ThomasKulin/CG-490/Report/simulations/FEMM/BasicSim Field Intensity.PNG

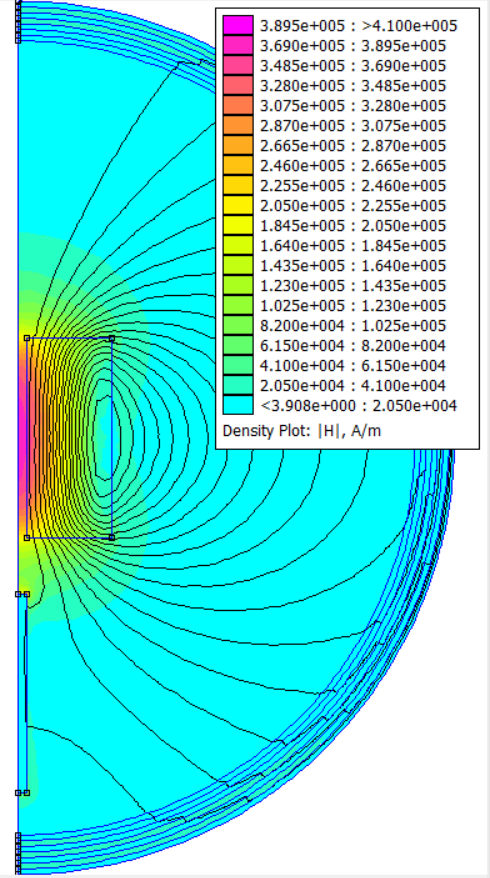
Report/simulations/FEMM/BasicSim Field Intensity.PNG
