ThomasKulin/CG-490/Report/shematics + boards/PowerSwitchV1 3d.PNG

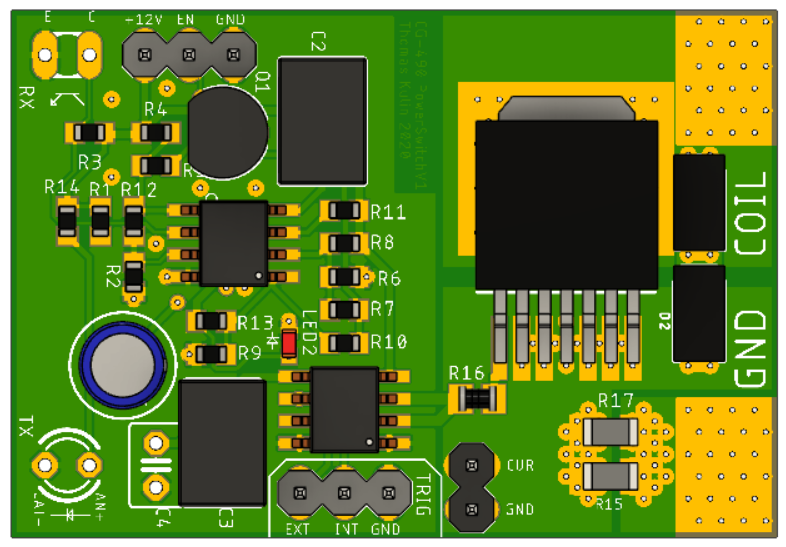
Report/shematics + boards/PowerSwitchV1 3d.PNG
