ThomasKulin/CG-490/README.md

# CG-490
shooting stuff with electricity. yes
