ThomasKulin/CG-490/Cool Links.txt

Insprational Projects

full auto bb gun. good aesthetic: https://www.eevblog.com/forum/projects/my-electromagnetic-bb-gun-project-130-ms-velocity-20-rpm-rate-of-fire/
Battery powered, tons of helpful info: https://4hv.org/e107_plugins/forum/forum_viewtopic.php?p=1&id=147269
CG42 THE ONE THE ONLY: https://4hv.org/e107_plugins/forum/forum_viewtopic.php?p=6&id=100083

Concepts

diode suppression: https://4hv.org/e107_plugins/forum/forum_viewtopic.php?p=1&id=147858

Components

Digital logic optical sensor: https://www.digikey.com/product-detail/en/OPB819Z/365-1262-ND/1015177
Mosfet alternative (cheaper): https://www.digikey.ca/product-detail/en/STP310N10F7/497-13233-5-ND/3598099
gate driver: https://www.digikey.ca/product-detail/en/microchip-technology/MCP1407-E-SN/MCP1407-E-SN-ND/1228639
TVS diode: https://www.digikey.ca/product-detail/en/littelfuse-inc/SMDJ28A/SMDJ28ACT-ND/1835367
Barrel: https://www.amazon.ca/Clear-Polycarbonate-Tubing-Wall-Length/dp/B000OM9JPG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
