ThomasKulin/CG-490/Papers/final presentation example.pdf

# Multistage Coil Gun

## Final Presentation

Team 3

Yohan Ko, Jon Dagdagan, Shashvat Nanavati TA: Ryan May
ECE 445

Friday April 26, 2013

Benefits
- Controllable projectile
speed
- Portable, easy to
assemble
- Educational tool to teach electromagnetism

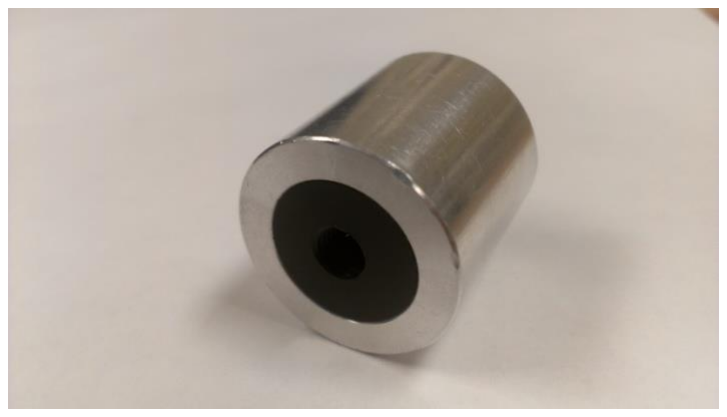
[picture p62: figure]

Features
- Isolation of high voltage components
- Sensing capabilities in
launch barrel
- Fast capacitor recharge time

Objectives
•Eject projectile at speeds of 12-17 m/s •Trigger successive stage efficiently •Ensure operator and system safety •Design for modularity
•Make project permanent EOH exhibit

## Coil Gun Theory

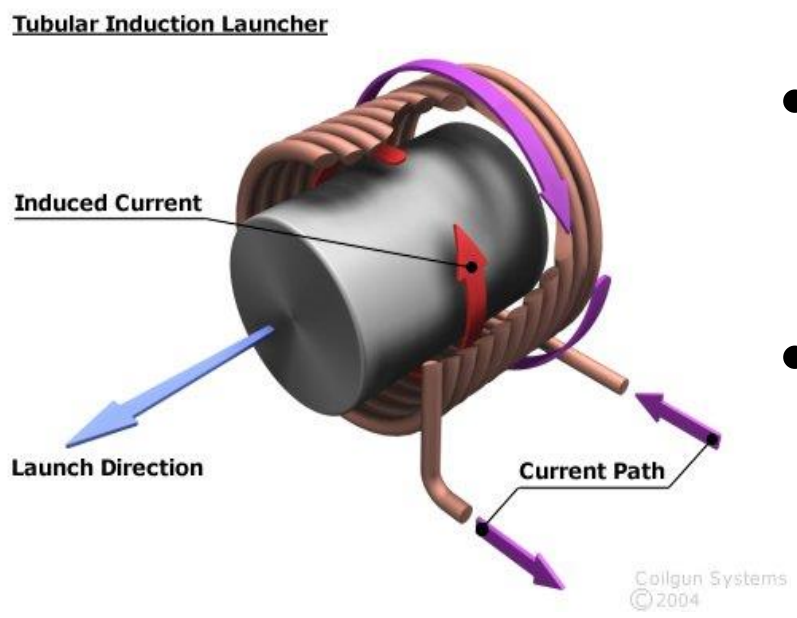
[picture p63: figure]

## - Lenz’s Law

– Induced surface
currents

## - Opposing currents repel each other

Figure taken from [2]

## Overview

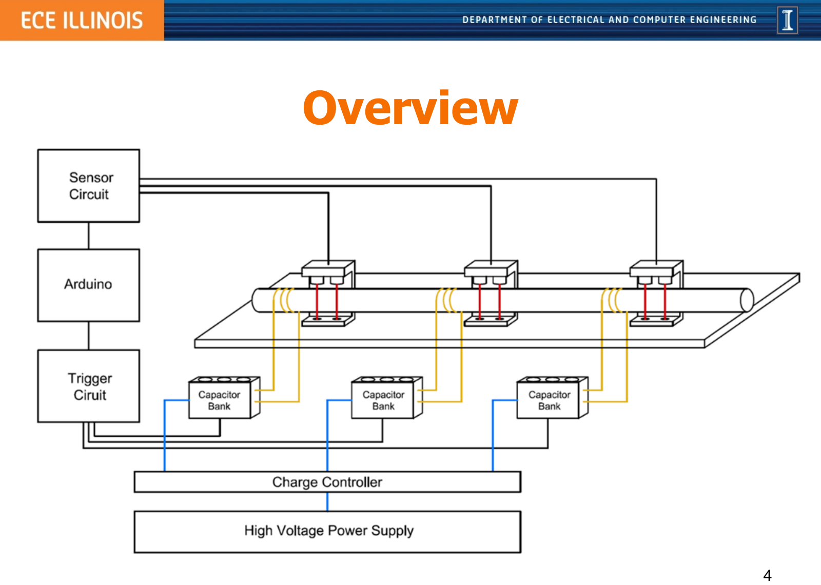
[picture p64: page 4]

## Charge Controller and HV Power Supply

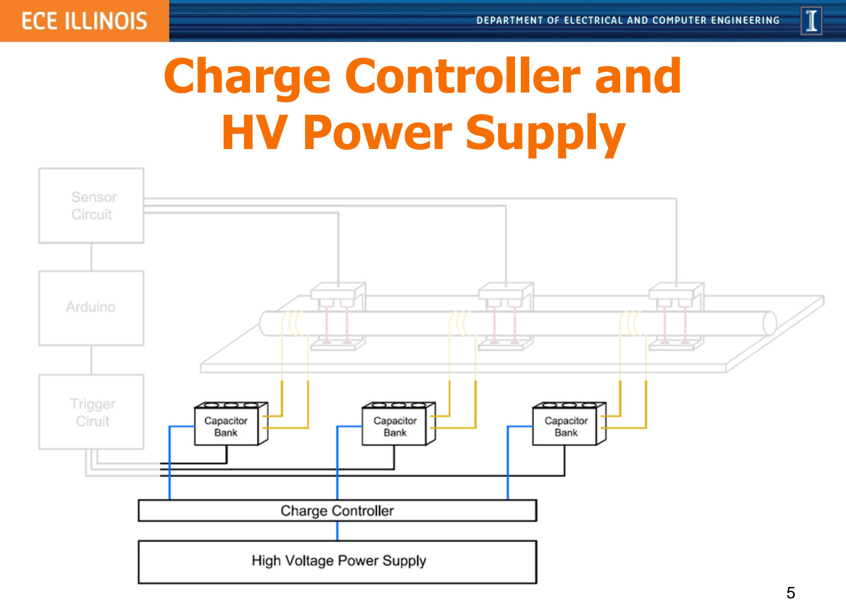
[picture p65: page 5]

## Charge Controller and HV Power Supply

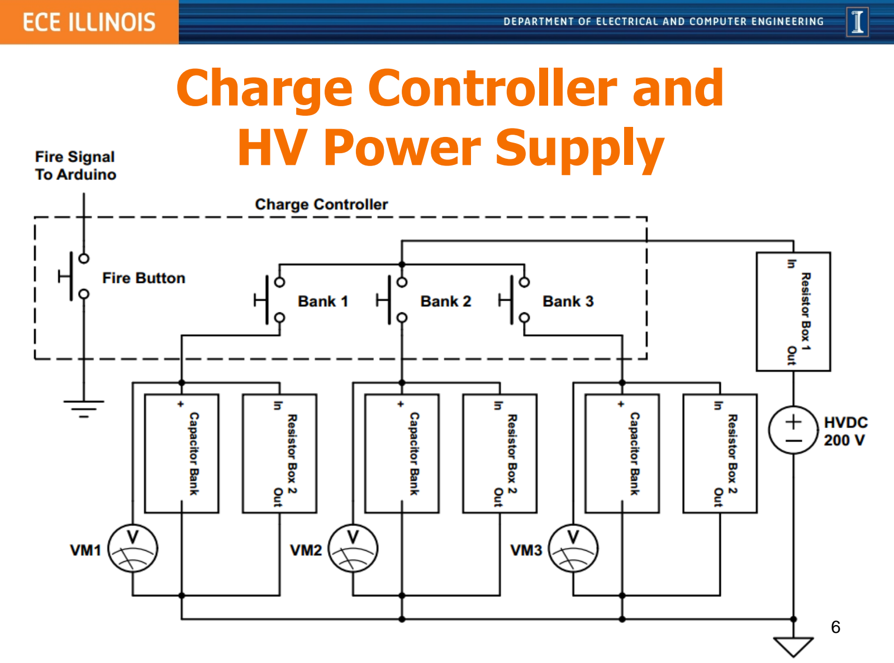
[picture p66: page 6]

## Sensor Circuit

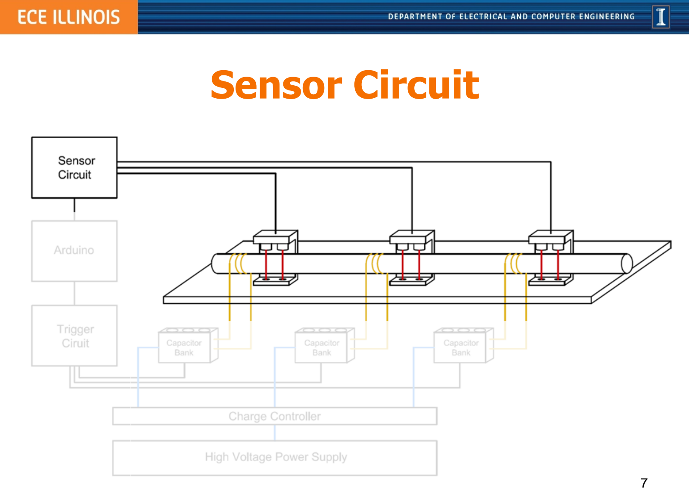
[picture p67: page 7]

## Sensor Circuit

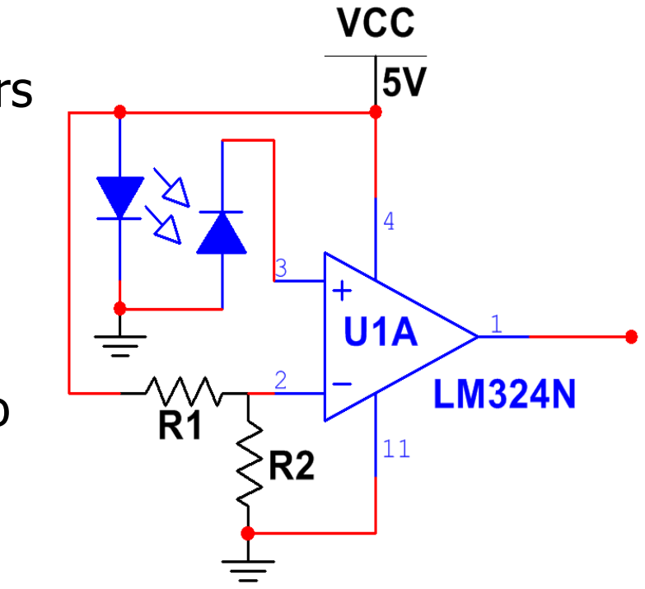
[picture p68: figure]

- Interface between lasers and Arduino
- Detects voltage drop
when projectile passes
lasers
- Outputs stable signal to Arduino

## Sensor Circuit

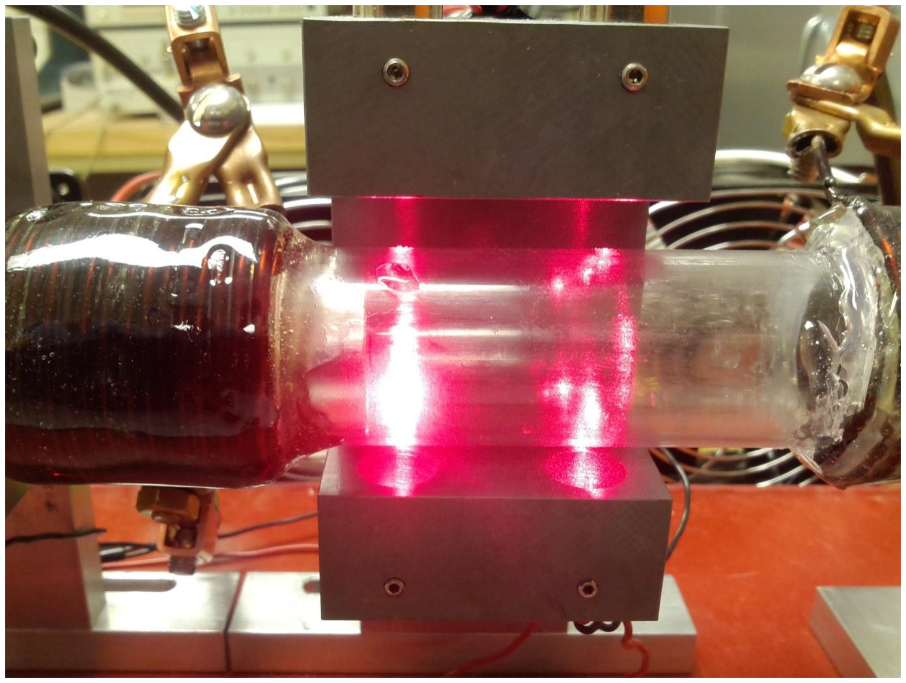
[picture p69: figure]

## Microcontroller

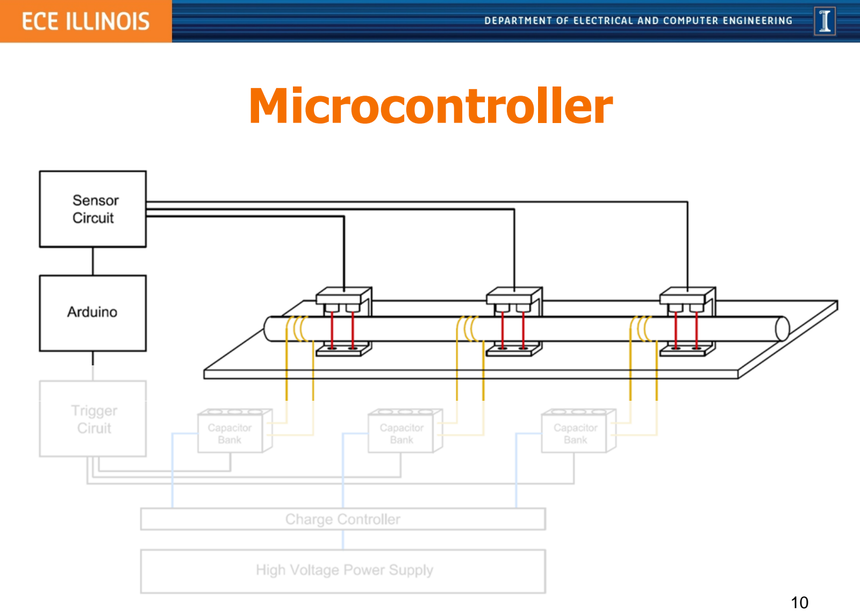
[picture p70: page 10]

## Microcontroller

- Uses Arduino Uno

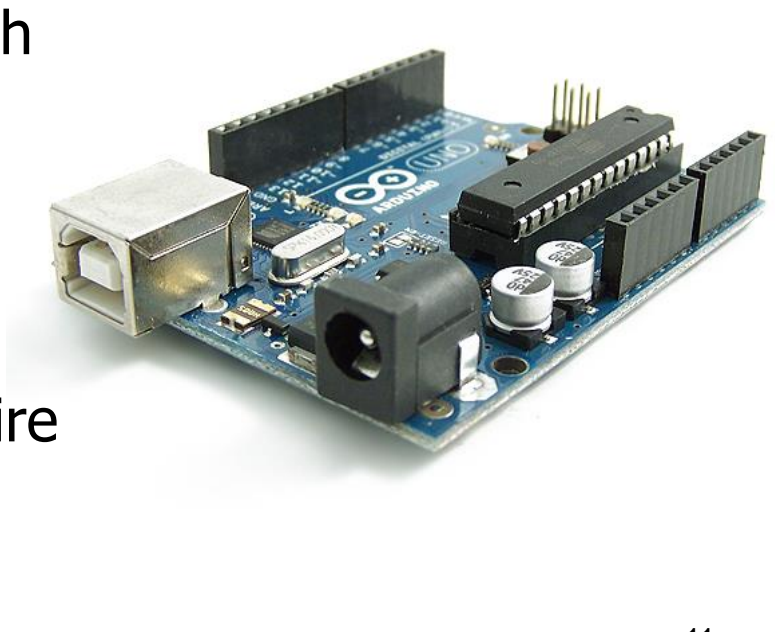
[picture p71: figure]

- Records times at which
voltage of photodiode
drops
- Calculates speed of
projectile
- Determines when to fire
next stage

## Trigger Circuit

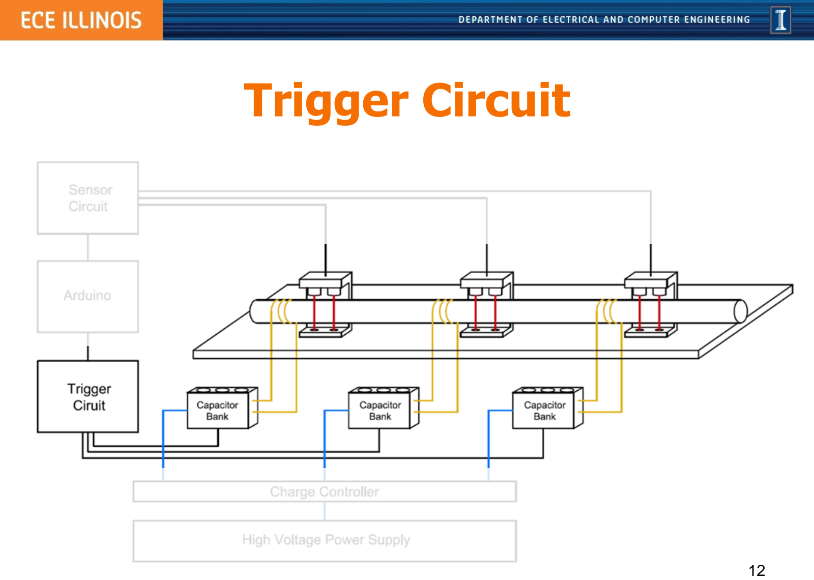
[picture p72: page 12]

## Trigger Circuit

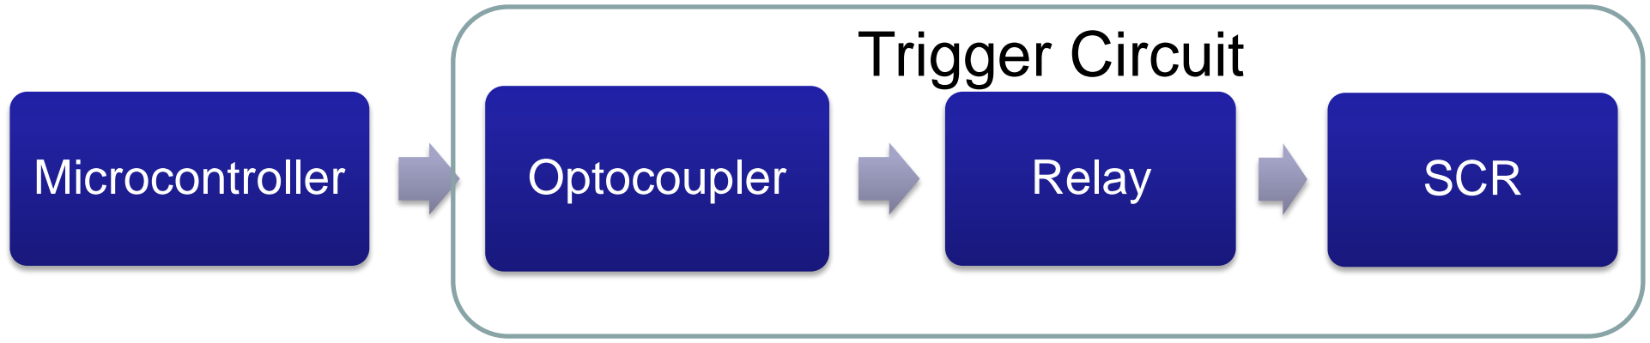
[picture p73: figure]
Microcontroller; Optocoupler; Relay; SCR; Trigger Circuit

- Optocoupler provides isolation from HV power supply
- Relay drives the gate of SCR to turn SCR on
- SCR remains latched on until all current is discharged

## Trigger Circuit

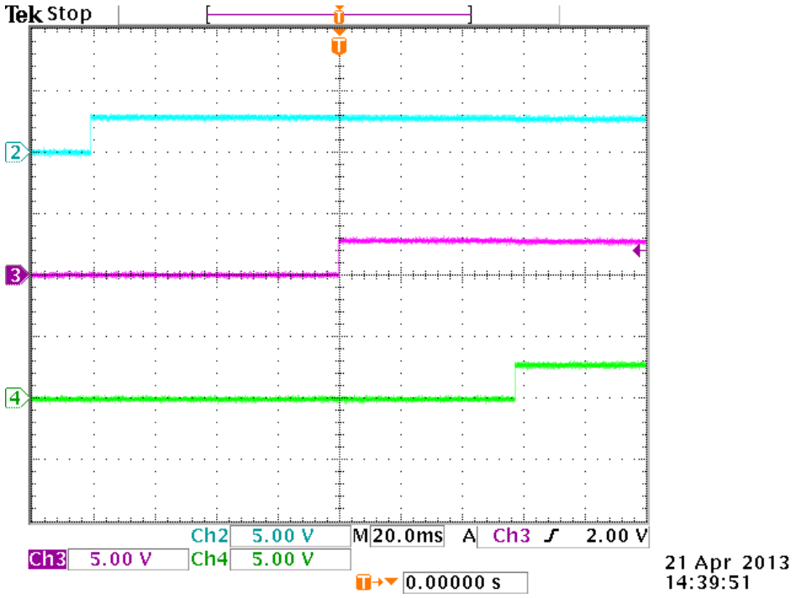
[picture p74: figure]

Sequential Triggering of Capacitor Banks

## Coil Windings

### - Coil windings connected to each capacitor bank - Design Considerations

– Minimum resistance
- Place two windings in parallel for each stage – Maximum mutual inductance
- length of winding = length of projectile
- diameter of winding = diameter of projectile

## Simulations

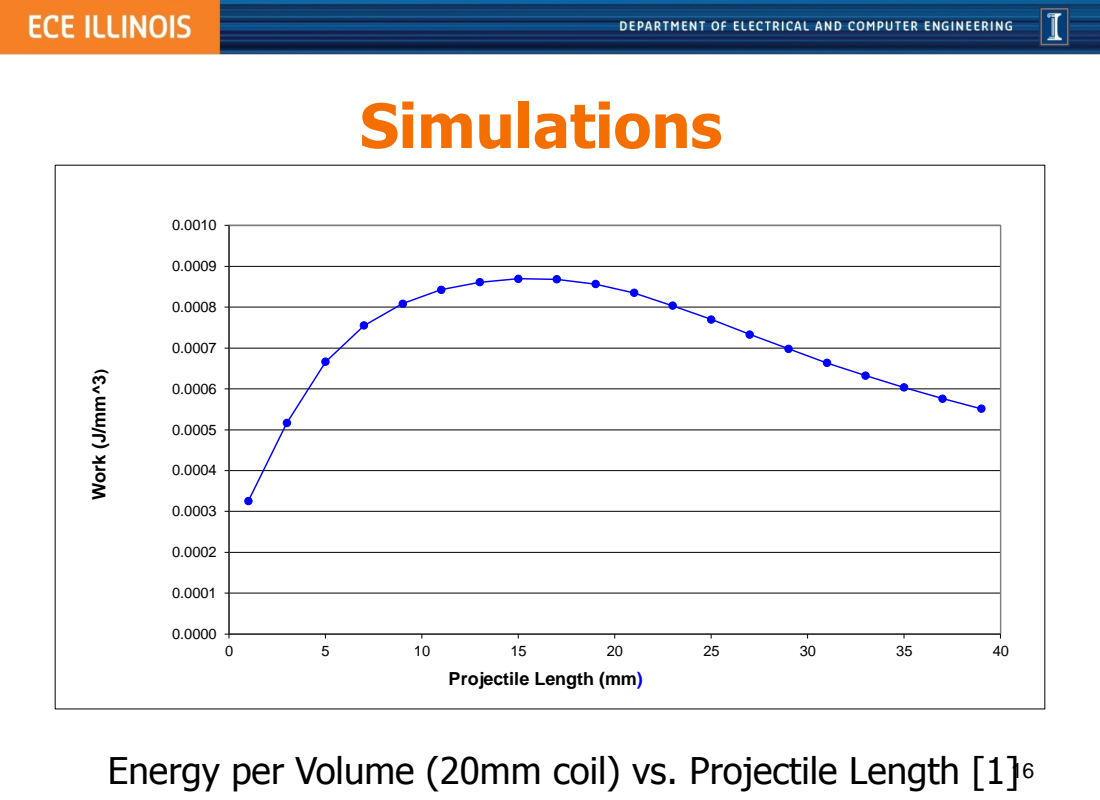
[picture p75: page 16]
Work (J/mm^3)

Projectile Length (mm)

Energy per Volume (20mm coil) vs. Projectile Length [1]

## Simulations

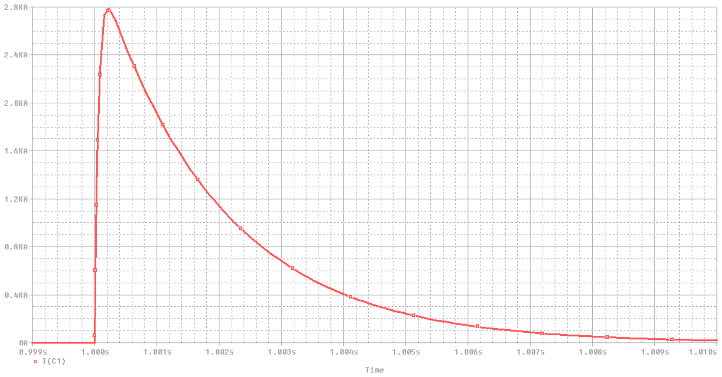
[picture p76: figure]

Peak Current Plot | 17

Requirement | Verification
- Calculate and use speed of projectile to obtain discharge time | • Push projectile through barrel and ensure monitor displays logged times and speed
- 2400 V isolation between HV power supply and Arudino | • Ensure resistance across DC power relay is in 10MΩ range
- Relay output signal powerful enough to activate SCRs | • Ensure relay outputs 3V±20% with 500mA±20%

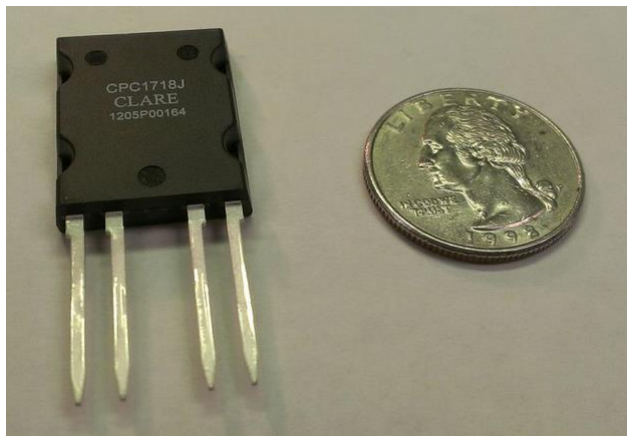
[picture p77: figure]

Challenges | Solutions
- False triggering from noise | • Decoupling capacitors
- High component stress | • Smaller diameter barrel • Operate at lower voltage
- High voltage safety | • Capacitor bank enclosure • Safety procedures
- Magnetic field interference | • Twisted wires to cancel magnetic fields • Shielded wire
- Arduino failure | • Proper grounding practice

## Ethics

1. To accept responsibility in making decisions consistent with the safety, health, and welfare of the public, and to disclose promptly factors that might endanger the public or the environment.
3. To be honest and realistic in stating claims or estimates based on available data.
7. To seek, accept, and offer honest criticism of technical work, to acknowledge and correct errors, and to credit properly the contributions of others.
9. To avoid injuring others, their property, reputation, or employment by false or malicious action.

## Safety Features

- Capacitor bank enclosures
- Capacitor bank shorting rods
- Side insertion plugs for wiring modularity

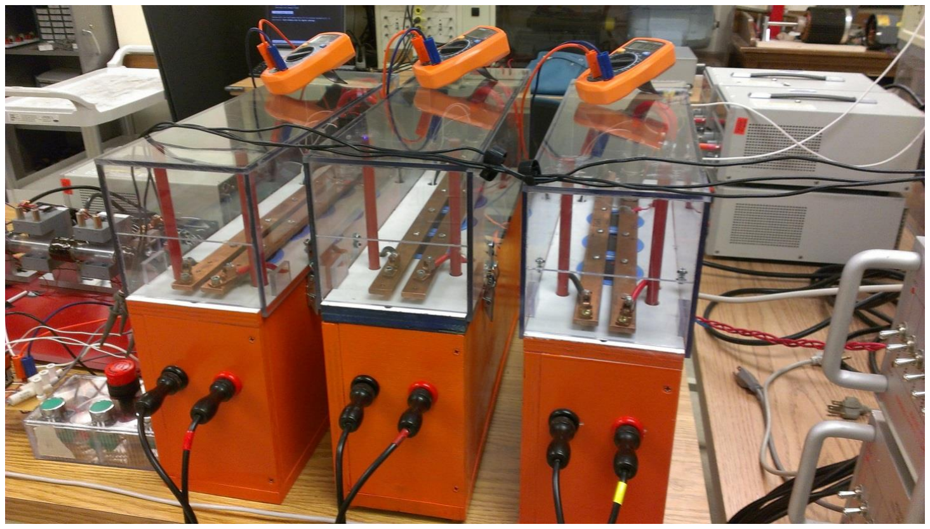
[picture p78: figure]

## Safety Features

- Use of multiple SCRs in parallel
- Safety plans for connect/disconnect/operation

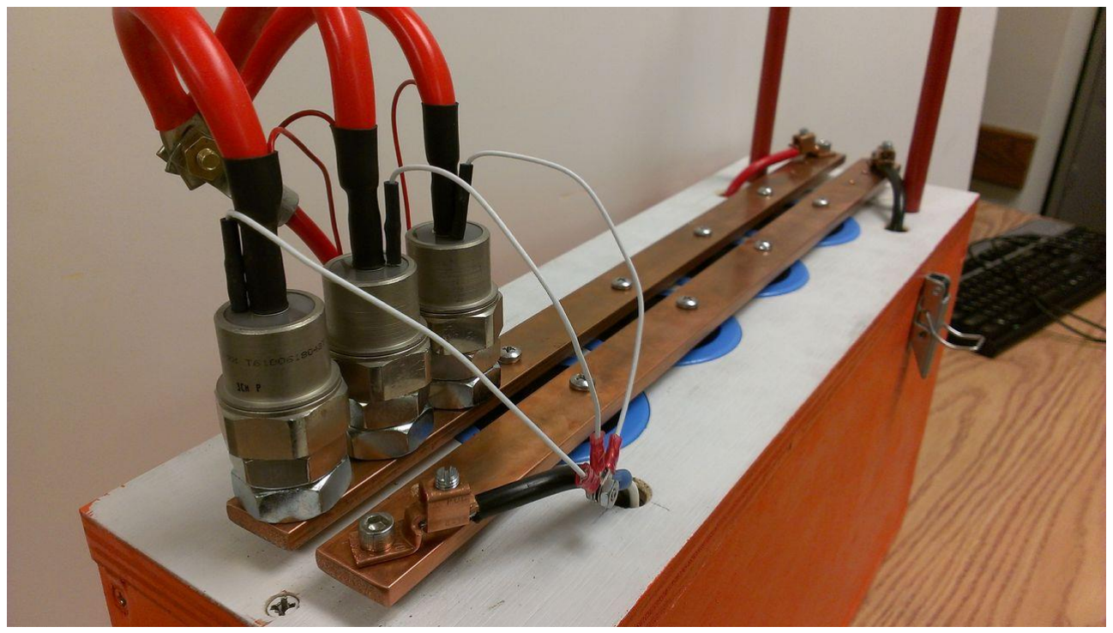
[picture p79: figure]

## Engineering Open House

### - Prototype demonstration successful

– Won 2nd in “Back to School” category
– Operated over 100 times over two days
– Consistently achieved projectile speeds of 14-17 m/s

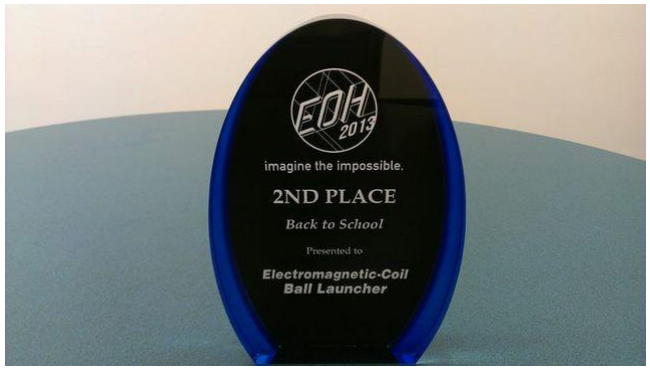
[picture p80: figure]

## Engineering Open House

### - Lessons Learned

– Windings need to be more secure
– Signals need to be immune from field interference – Need to lower current stress levels on SCR
– Capacitor voltages can rise after disconnection

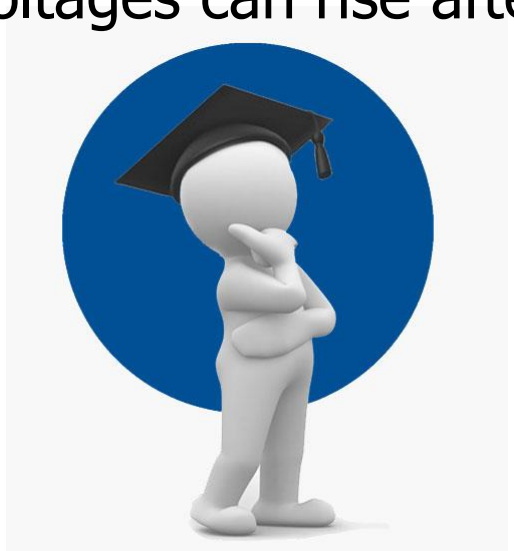
[picture p81: figure]

## Functionality Demonstration

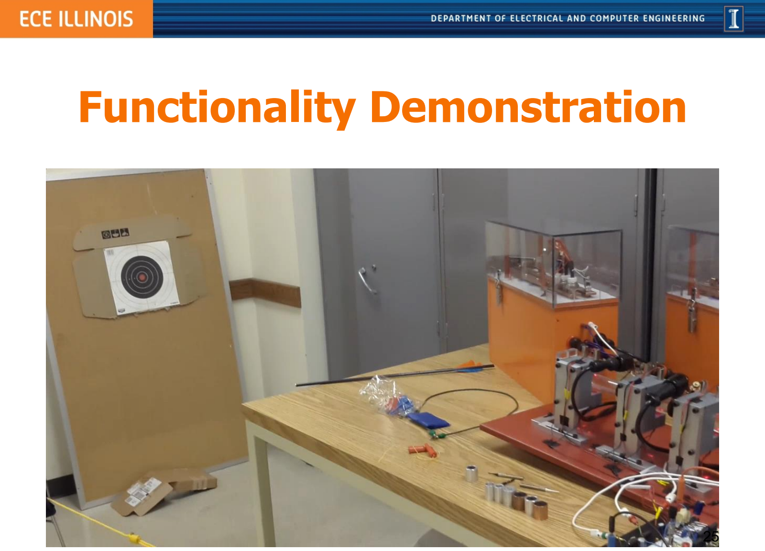
[picture p82: page 25]

## Next Steps

## - Continue Coil Gun EOH exhibit - Silk-screened PCB - Enclosure for barrel

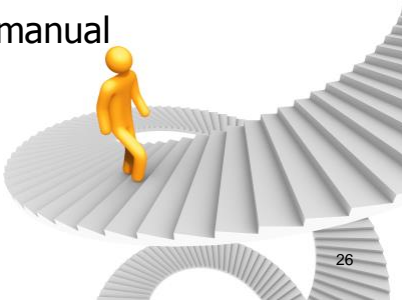
[picture p83: figure]

## - Create operational manual

## Thank You

## - Special thanks to:

– Ryan May
– Karl Reinhard
– Shawn Reinhard
– Christopher Barth
– Dr. Scott Carney
– Friends from the Machine and Parts shop – Kevin Colravy

## Questions?

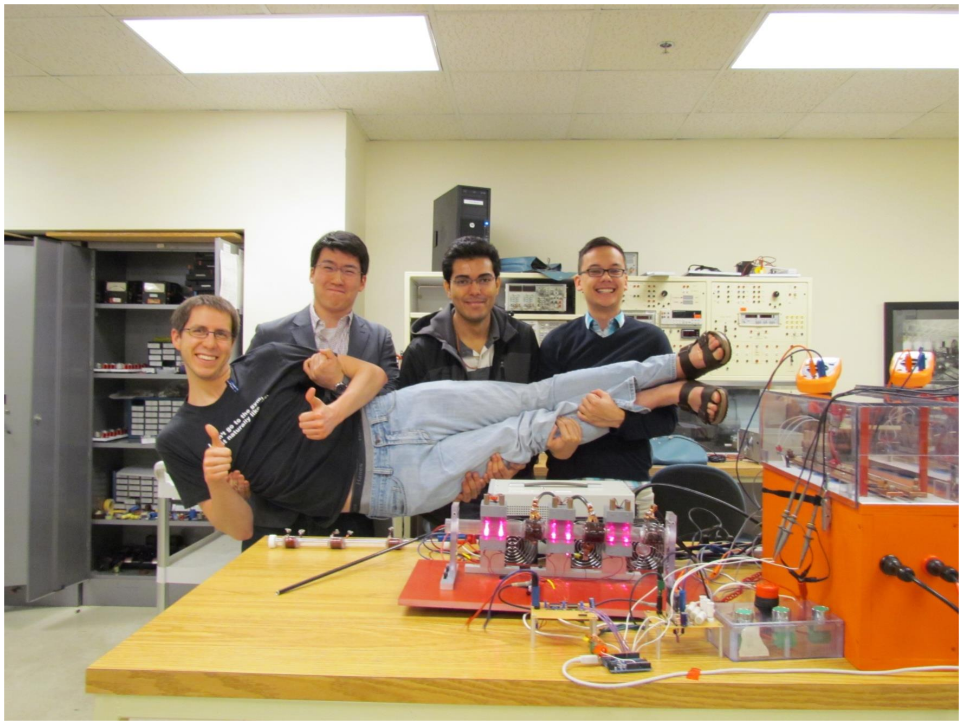
[picture p84: figure]

## References

[1] Hansen, Barry. (2013) Solving Solid Cylindrical Projectile of various lengths. Available:
http://www.coilgun.info/femm/projectile_length/projectile_length_results.txt
[2] Paul, James. (2006) Coilgun Basics.
Available: http://www.coilgun.eclipse.co.uk/coilgun_basics_1.html
