ThomasKulin/CG-490/FEMM Simulations/Data/3.2mmCoil_100T_246A Force vs. Projectile distance.png

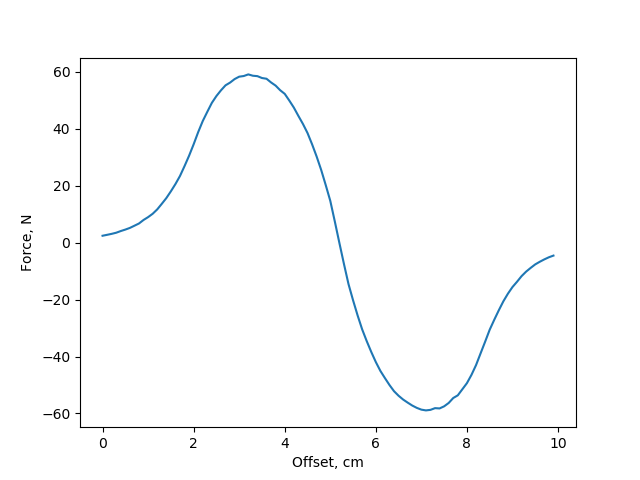
FEMM Simulations/Data/3.2mmCoil_100T_246A Force vs. Projectile distance.png
