ThomasKulin/CG-490/FEMM Simulations/Data/7mmCoil_192T_156A Force vs. Projectile distance.png

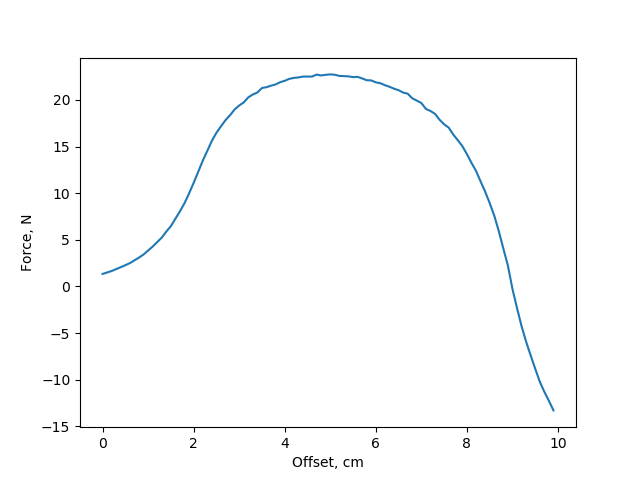
FEMM Simulations/Data/7mmCoil_192T_156A Force vs. Projectile distance.png
