ThomasKulin/CG-490/Report/Datasheets/STP310NF10F7 SOA.PNG

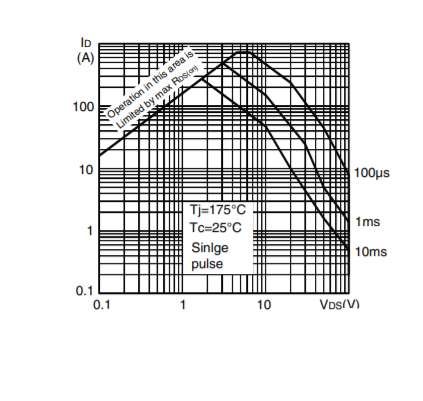
Report/Datasheets/STP310NF10F7 SOA.PNG
