ThomasKulin/CG-490/Report/Lorentz Force Graphic.png

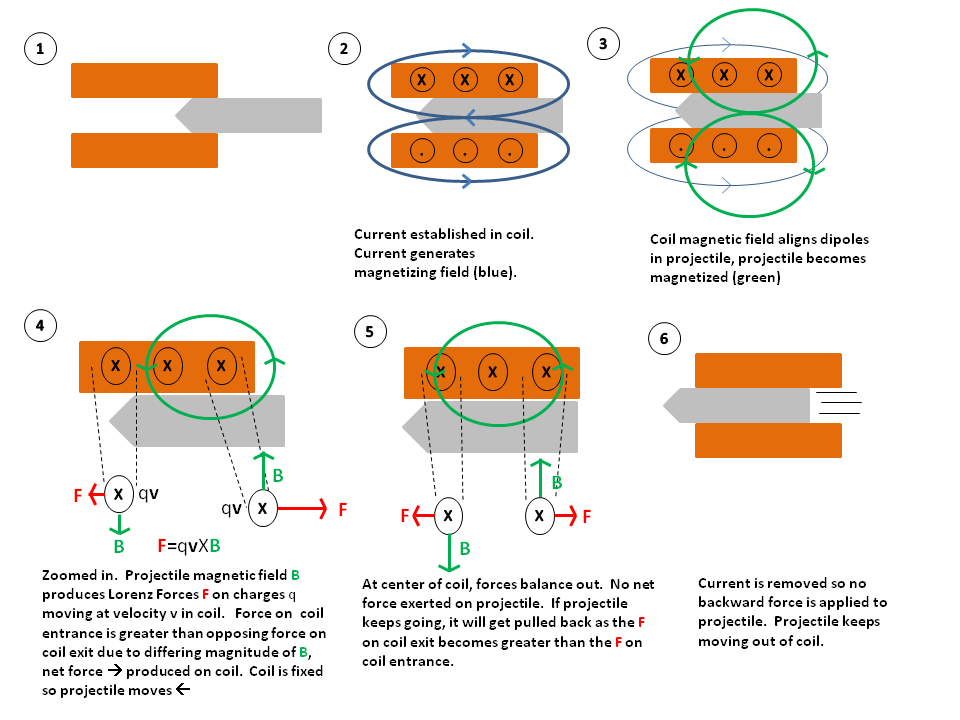
Report/Lorentz Force Graphic.png
