ThomasKulin/CG-490/Report/shematics + boards/PowerSwitchV1 brd.PNG

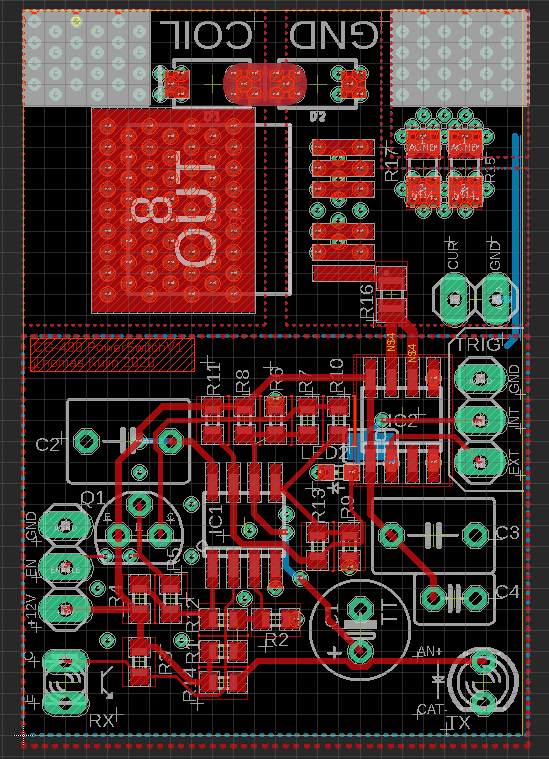
Report/shematics + boards/PowerSwitchV1 brd.PNG
