ThomasKulin/CG-490/Report/shematics + boards/PowerSwitchV1 sch.PNG

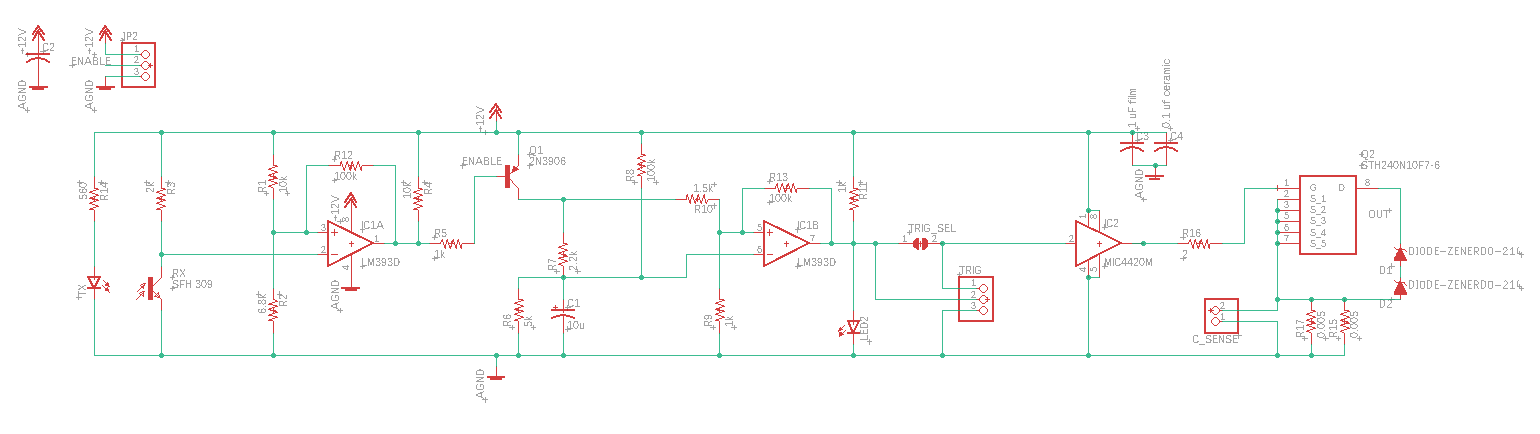
Report/shematics + boards/PowerSwitchV1 sch.PNG
