ThomasKulin/CG-490/Report/shematics + boards/Proto_V1.jpg

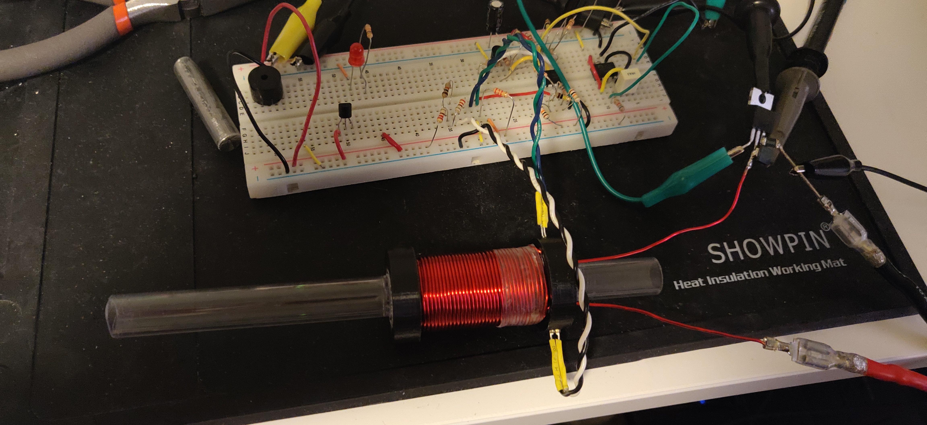
Report/shematics + boards/Proto_V1.jpg
