ThomasKulin/CG-490/Report/simulations/SPICE/Antiparallel Diode Waveform.PNG

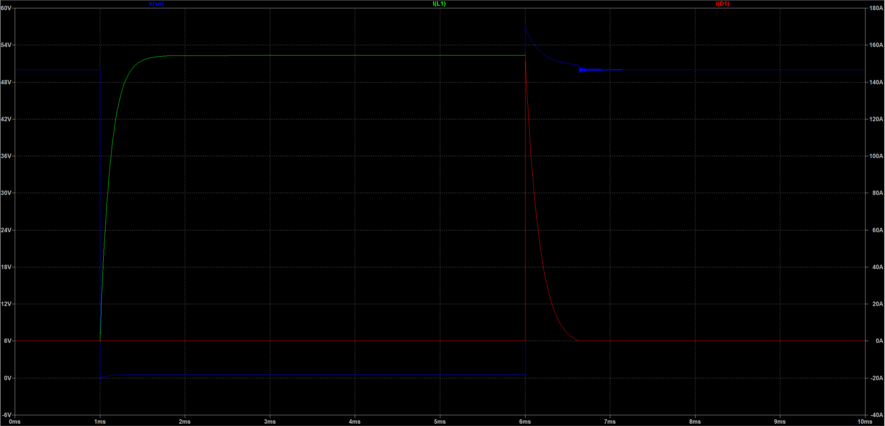
Report/simulations/SPICE/Antiparallel Diode Waveform.PNG
