ThomasKulin/CG-490/Report/simulations/SPICE/Diodeless Waveform.PNG

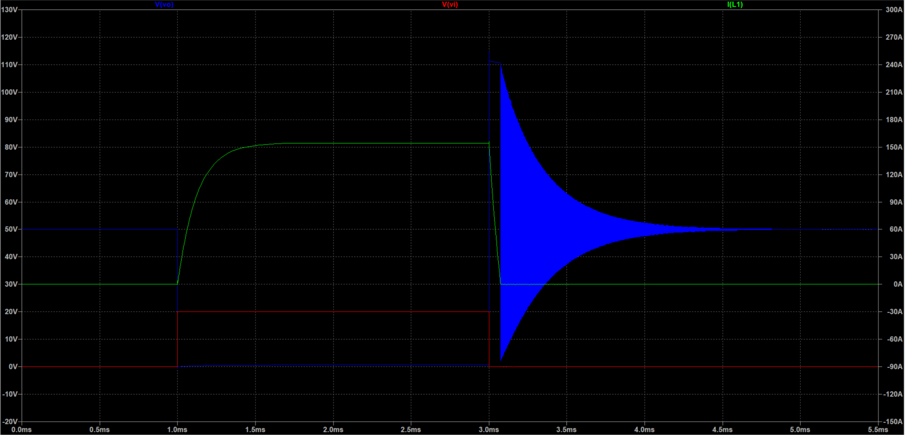
Report/simulations/SPICE/Diodeless Waveform.PNG
