ThomasKulin/CG-490/Report/simulations/SPICE/LTSpice D_AntiParallel.PNG

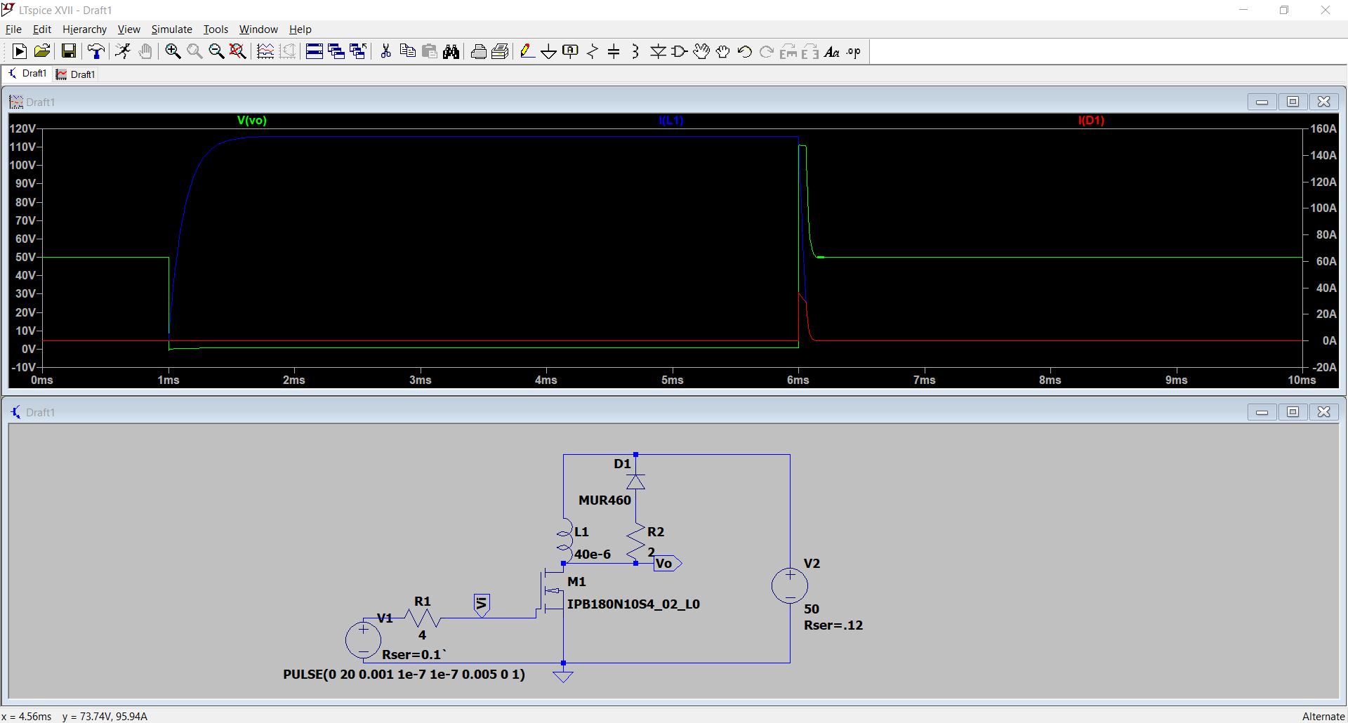
Report/simulations/SPICE/LTSpice D_AntiParallel.PNG
