ThomasKulin/CG-490/Report/simulations/SPICE/LTSpice D_zener60v.PNG

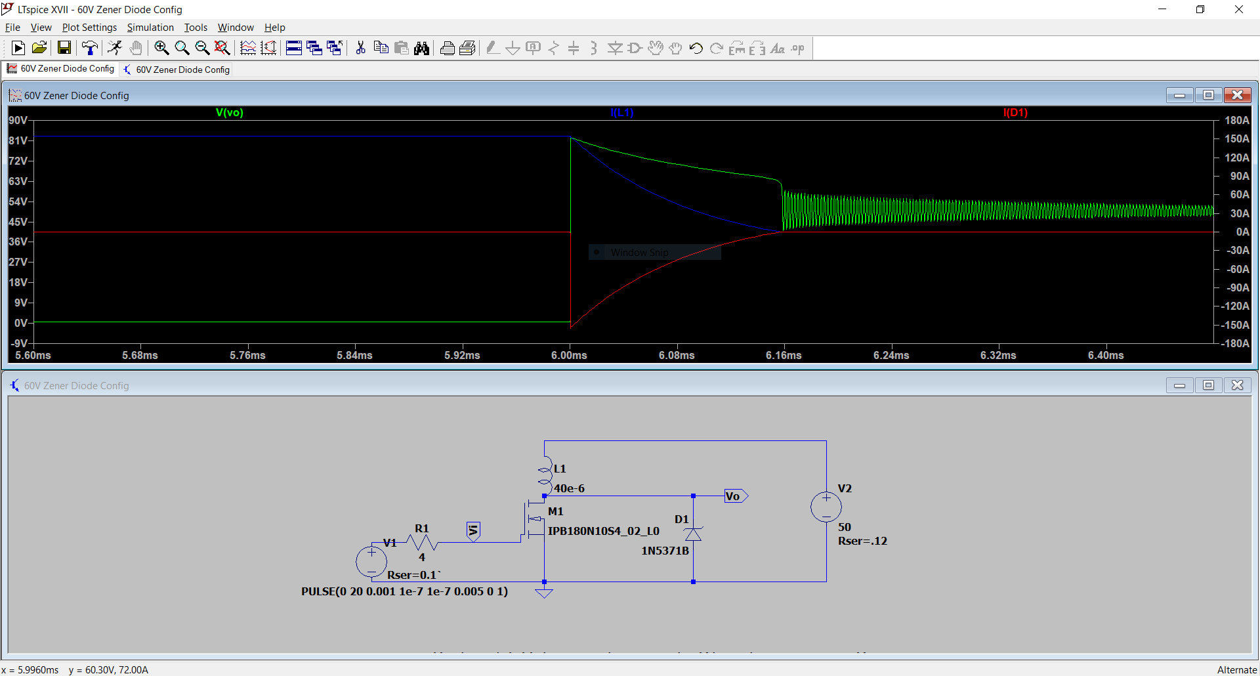
Report/simulations/SPICE/LTSpice D_zener60v.PNG
