ThomasKulin/CG-490/Report/simulations/SPICE/OpticalTrigger Reset Simulation.PNG

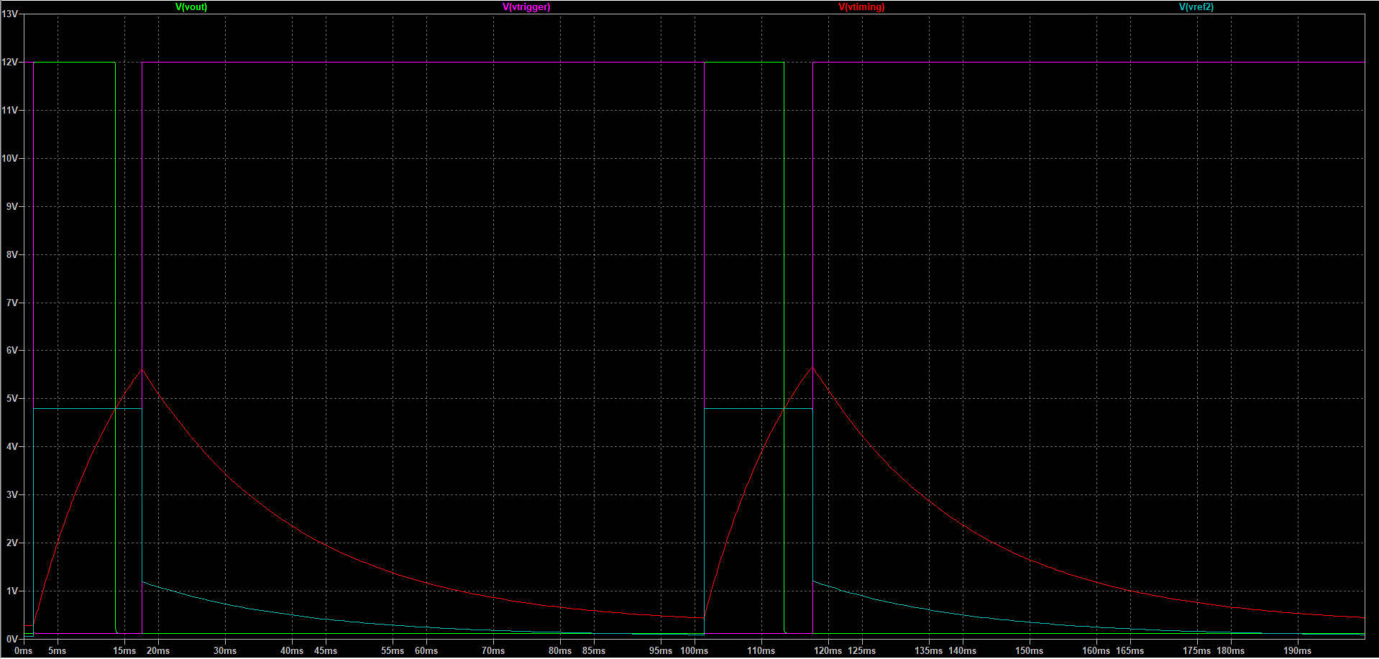
Report/simulations/SPICE/OpticalTrigger Reset Simulation.PNG
