ThomasKulin/CG-490/Report/simulations/SPICE/OpticalTrigger Simulation.PNG

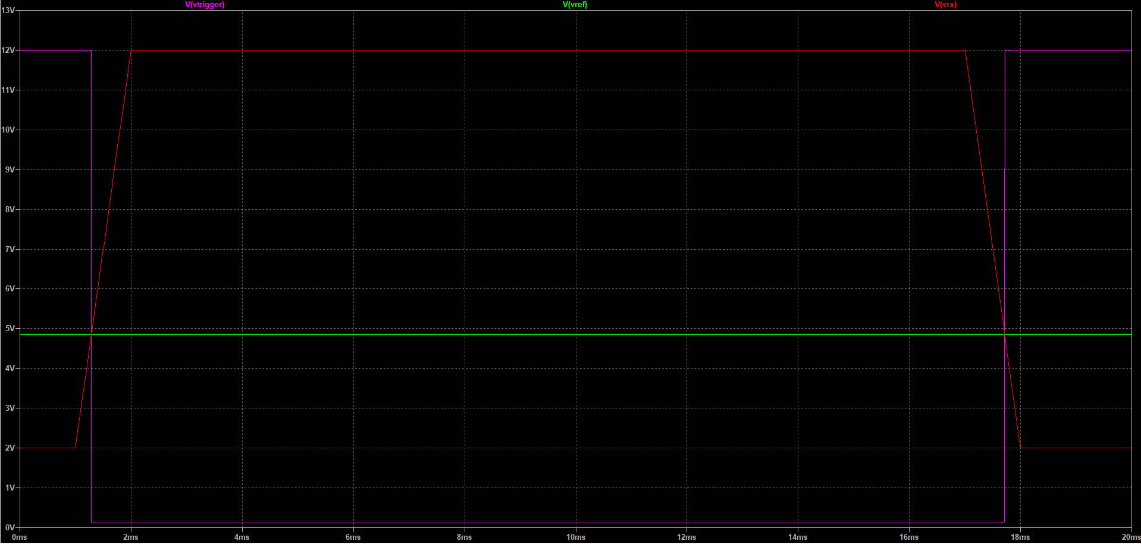
Report/simulations/SPICE/OpticalTrigger Simulation.PNG
