ThomasKulin/CG-490/Report/simulations/SPICE/PowerSwitchV1 IPB180N10S402 Electrical simulation.PNG

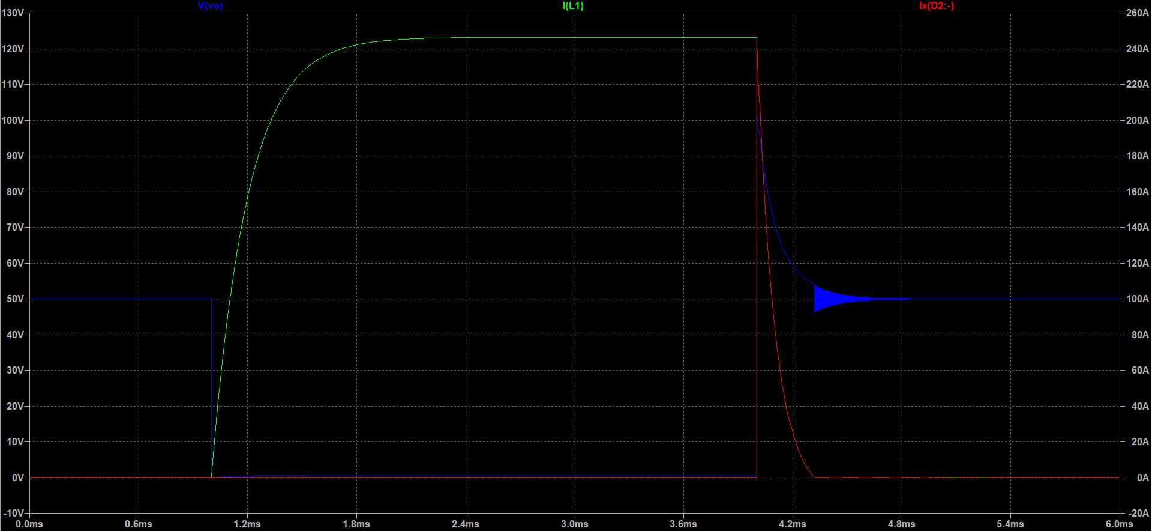
Report/simulations/SPICE/PowerSwitchV1 IPB180N10S402 Electrical simulation.PNG
