ThomasKulin/CG-490/Report/simulations/SPICE/PowerSwitchV1 STP310N10F7 Thermal simulation.PNG

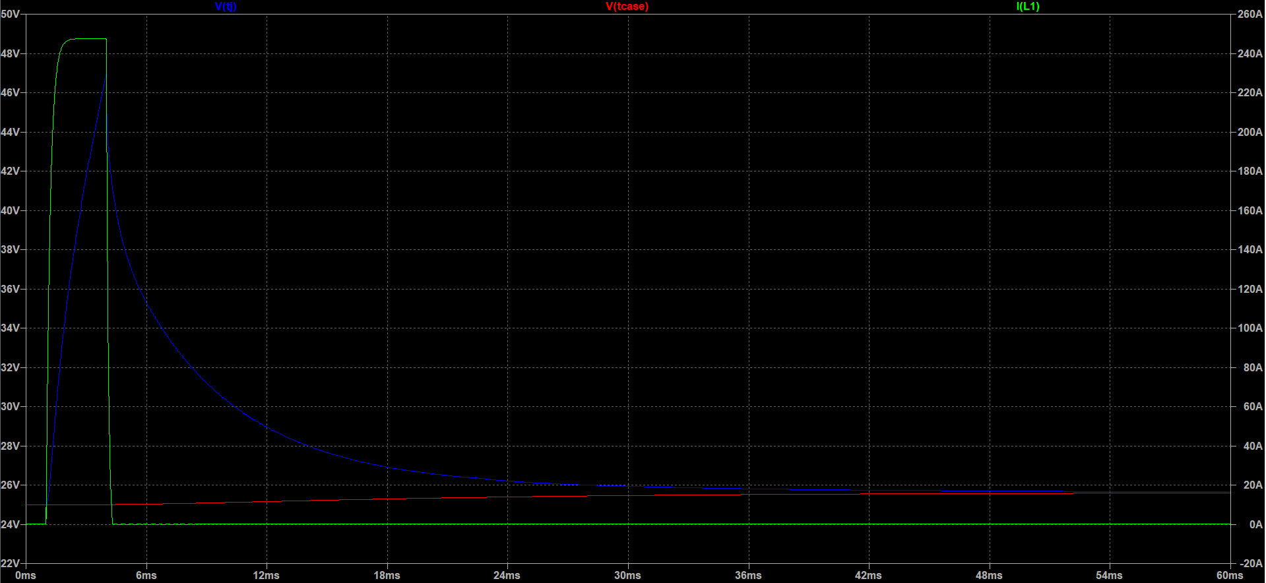
Report/simulations/SPICE/PowerSwitchV1 STP310N10F7 Thermal simulation.PNG
