ThomasKulin/CG-490/Report/simulations/SPICE/Push Pull Waveform.PNG

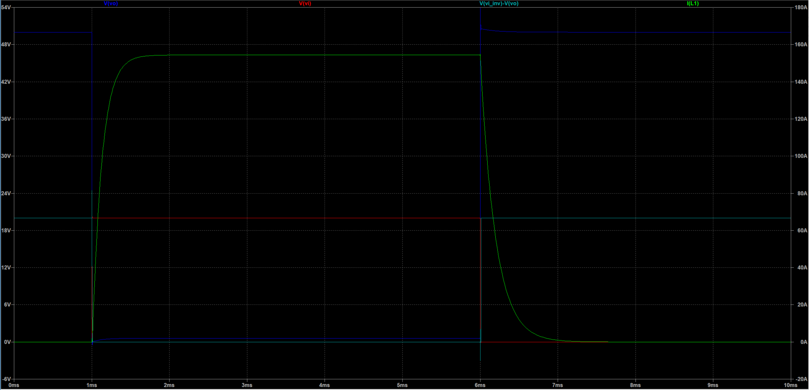
Report/simulations/SPICE/Push Pull Waveform.PNG
