ThomasKulin/CG-490/Report/simulations/SPICE/Zener Diode Waveform.PNG

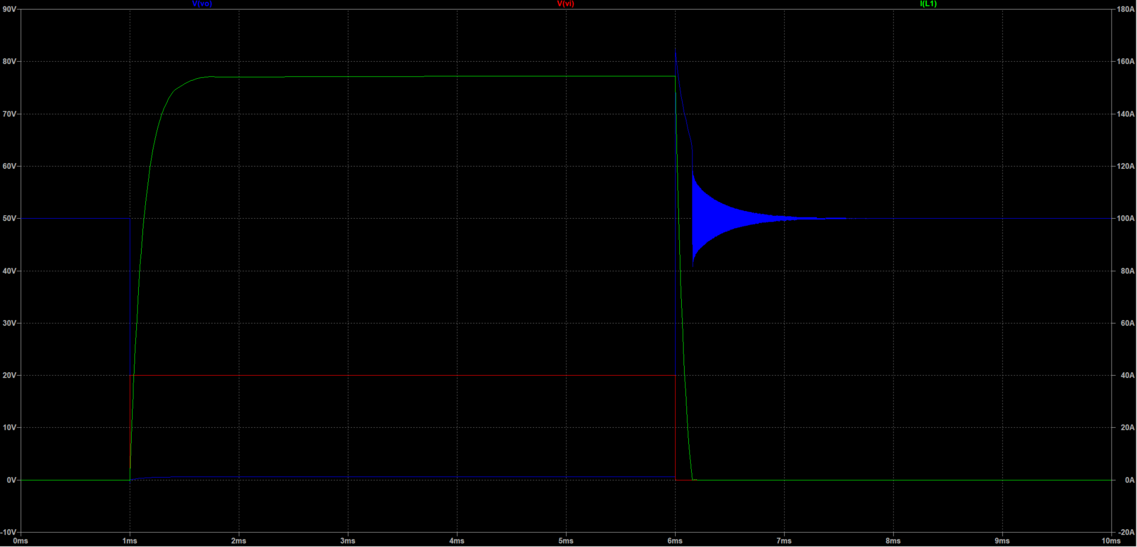
Report/simulations/SPICE/Zener Diode Waveform.PNG
