ThomasKulin/CG-490/Report/final components order.xls

CG490
Mouser # | Mfr. # | Manufacturer | Customer # | Description | RoHS | Lifecycle | Order Qty. | Price (CAD) | Ext.: (CAD)
511-STH240N10F7-6 | STH240N10F7-6 | STMicroelectronics |  | MOSFET N-channel 100 V, 0.002 Ohm typ., 180 A STripFET F7 Power MOSFET in a H2PAK-6 package | RoHS Compliant |  | 10 | $4.12 | $41.20
579-MCP1407T-E/SN | MCP1407T-E/SN | Microchip |  | Gate Drivers 6A Sngl MOSFET Drvr | RoHS Compliant |  | 10 | $1.45 | $14.50
720-SFH309FA | SFH 309 FA | Osram Opto Semiconductor |  | Phototransistors PHOTOTRANSISTOR | RoHS Compliant |  | 10 | $0.569 | $5.69
595-LM393BIDR | LM393BIDR | Texas Instruments |  | Analog Comparators Dual standard comparator 8-SOIC -40 to 85 | RoHS Compliant | New Product | 10 | $0.44 | $4.40
828-OP266B | OP266B | TT Electronics |  | Infrared Emitters Infrared 890nm | RoHS Compliant |  | 10 | $1.49 | $14.90
71-CRCW06031K00FKEAC | CRCW06031K00FKEAC | Vishay |  | Thick Film Resistors - SMD 1/10Watt 1Kohms 1% Commercial Use | RoHS Compliant By Exemption |  | 100 | $0.014 | $1.40
71-CRCW060310K0JNEBC | CRCW060310K0JNEBC | Vishay |  | Thick Film Resistors - SMD 1/10Watt 10Kohms 5% Commercial Use | RoHS Compliant By Exemption |  | 30 | $0.043 | $1.29
603-AC0603FR-135K1L | AC0603FR-135K1L | Yageo |  | Thick Film Resistors - SMD 5.1K ohm 1% 75V AEC-Q200 | RoHS Compliant By Exemption | New Product | 10 | $0.031 | $0.31
71-CRCW06032K20FKEAC | CRCW06032K20FKEAC | Vishay |  | Thick Film Resistors - SMD 1/10Watt 2.2Kohms 1% Commercial Use | RoHS Compliant By Exemption |  | 10 | $0.037 | $0.37
603-RC0603FR-071K5L | RC0603FR-071K5L | Yageo |  | Thick Film Resistors - SMD 1.5K OHM 1% | RoHS Compliant By Exemption |  | 10 | $0.026 | $0.26
71-CRCW0603100KFKEAC | CRCW0603100KFKEAC | Vishay |  | Thick Film Resistors - SMD 1/10Watt 100Kohms 1% Commercial Use | RoHS Compliant By Exemption |  | 30 | $0.047 | $1.41
279-CRGH1206F560R | CRGH1206F560R | TE Connectivity |  | Thick Film Resistors - SMD CRGH1206 1% 560R 0.5W | RoHS Compliant By Exemption |  | 10 | $0.053 | $0.53
667-ERJ-P06J2R0V | ERJ-P06J2R0V | Panasonic |  | Thick Film Resistors - SMD 0805 2ohms 0.5W 5% Tol AEC-Q200 | RoHS Compliant By Exemption |  | 10 | $0.072 | $0.72
588-PCS1206FR0050ET | PCS1206FR0050ET | Ohmite |  | Current Sense Resistors - SMD 1W 0.005 OHMS 1% | RoHS Compliant | New Product | 25 | $0.345 | $8.63
80-ESY156M035AC2AA | ESY156M035AC2AA | KEMET |  | Aluminum Electrolytic Capacitors - Radial Leaded 35V 15uF 105C 1k Hour Radial | RoHS Compliant |  | 10 | $0.185 | $1.85
512-2N3906TFR | 2N3906TFR | ON Semiconductor |  | Bipolar Transistors - BJT PNP Transistor General Purpose | RoHS Compliant |  | 10 | $0.204 | $2.04
78-SMC5K26A-M3/H | SMC5K26A-M3/H | Vishay |  | ESD Suppressors / TVS Diodes 5000W Pppm Uni TVS SMC (DO-214AB) | RoHS Compliant |  | 20 | $1.06 | $21.20
