ThomasKulin/CG-490/Report/490 Preliminary Parts.xlsx

Item | Quantity | Price (per 1 unit) | Price (total) | Description | Source
Amazon.ca (FREE SHIPPING WITH PRIME)
PolyCarbonate Tubing | 1 | $25.39 | $25.39 | Will be used for the barrel of the launcher | https://www.amazon.ca/Clear-Polycarbonate-Tubing-Wall-Length/dp/B000OM9JPG?s=hi
18 AWG Magnet Wire | 1 | $22.58 | $22.58 | Will be used to wind coils. The team may need more wire at a future date | https://www.amazon.ca/BNTECHGO-AWG-Magnet-Wire-Transformers/dp/B07GBNQ1DS
Digikey.ca ($8 SHIPPING)
STP310N10F7 | 1 | $5.80 | $5.80 | Preferred MOSFET | https://www.digikey.ca/product-detail/en/STP310N10F7/497-13233-5-ND/3598099/?itemSeq=307971246
IPB180N10S402ATMA1 | 1 | $8.36 | $8.36 | Alternate MOSFET | https://www.digikey.ca/product-detail/en/IPB180N10S402ATMA1/IPB180N10S402ATMA1CT-ND/6564454/?itemSeq=307971272
SMC5K24A-M3/I | 2 | $1.26 | $2.52 | Alternate TVS Diode | https://www.digikey.ca/product-detail/en/SMC5K24A-M3%2fI/SMC5K24A-M3%2fIGICT-ND/7427250/?itemSeq=308044939
SMC5K26A-M3/H | 2 | $1.26 | $2.52 | Preferred TVS Diode | https://www.digikey.ca/product-detail/en/SMC5K26A-M3%2fH/SMC5K26A-M3%2fHGICT-ND/7427251/?itemSeq=308045103
MCP1407-E/P | 1 | $1.50 | $1.50 | MOSFET Gate Driver IC | https://www.digikey.ca/product-detail/en/MCP1407-E%2fP/MCP1407-E%2fP-ND/1228640/?itemSeq=309333292
SFH 309 FA-5 | 1 | $0.85 | $0.85 | Optical Triggering Phototransistor | https://www.digikey.ca/product-detail/en/SFH+309+FA-5/475-3559-ND/2205897/?itemSeq=310185635
LM393P | 1 | $0.69 | $0.69 | Optical Triggering Dual Comparator | https://www.digikey.ca/product-detail/en/LM393P/296-1398-5-ND/277045/?itemSeq=310334813
R82DC4100AA60K | 10 | $0.43 | $4.35 | Decoupling Capacitors | https://www.digikey.ca/product-detail/en/R82DC4100AA60K/399-11515-ND/4833341/?itemSeq=310337642
OP266B | 1 | $1.48 | $1.48 | Optical Triggering Beam Source | https://www.digikey.ca/product-detail/en/OP266B/365-1591-ND/1636631/?itemSeq=311131232
Hobbyking.com (ORDER FROM US WAREHOUSE FOR FREE SHIPPING)
XT-60 connectors | 1 | $4.43 | $4.43 | for removable conenctions | https://hobbyking.com/en_us/genuine-xt60-nylon-connectors-male-female-5-pairs.html?wrh_pdp=2
10 AWG Black Wire | 2 | $4.63 | $9.26 | for high-current connections | https://hobbyking.com/en_us/turnigy-high-quality-10awg-silicone-wire-1m-black.html?wrh_pdp=2
10 AWG Red Wire | 2 | $4.63 | $9.26 | for high-current connections | https://hobbyking.com/en_us/turnigy-high-quality-10awg-silicone-wire-1m-red.html?wrh_pdp=2
6S 3000 mAh LiPo Battery | 2 | $54.24 | $108.47 | High Power Power source | https://hobbyking.com/en_us/turnigy-battery-3000mah-6s-40c-lipo-pack-xt-60.html?wrh_pdp=2
Total | $207.46 | CAD
