ThomasKulin/CG-490/CAD/Optics Assembly v2.stl

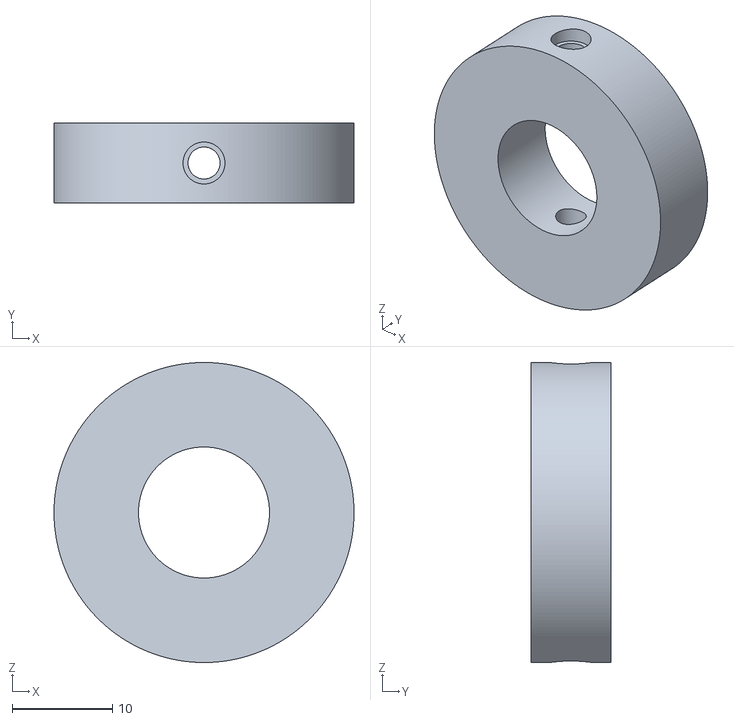
[picture p119: CAD file, 2020-02-10]
CAD/Optics Assembly v2.stl
30.0 x 8.00 x 30.0
