ThomasKulin/CG-490/CAD/components/CL23B_72_100_50_V.stp

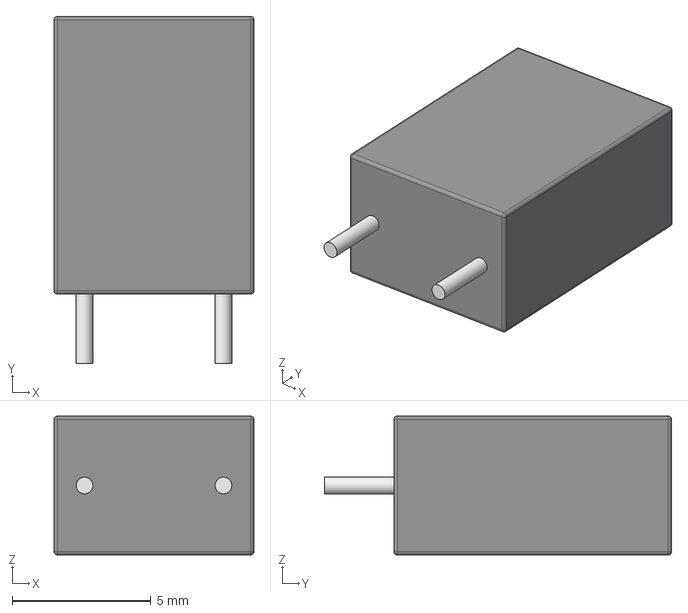
[picture p120: CAD file, 2020-03-10]
CAD/components/CL23B_72_100_50_V.stp
7.20 x 12.5 x 5.00 mm
