ThomasKulin/CG-490/CAD/Prototype Clamp Body.stl

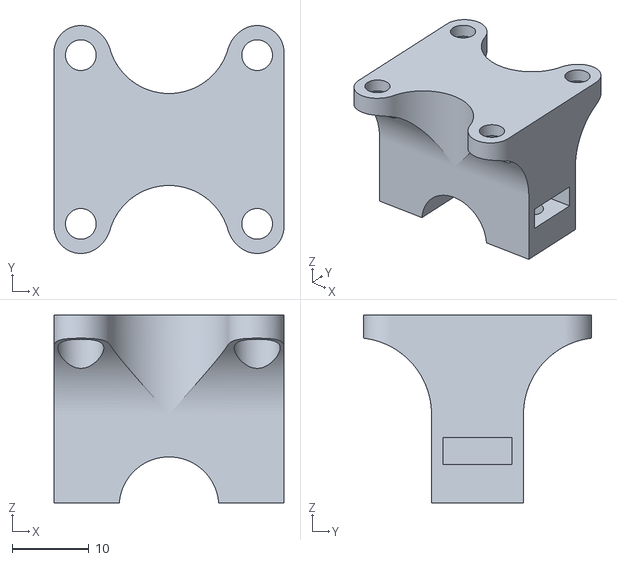
[picture p121: CAD file, 2020-09-17]
CAD/Prototype Clamp Body.stl
30.0 x 29.7 x 24.5
