ThomasKulin/CG-490/CAD/components/TO127P1500X470-8N.step

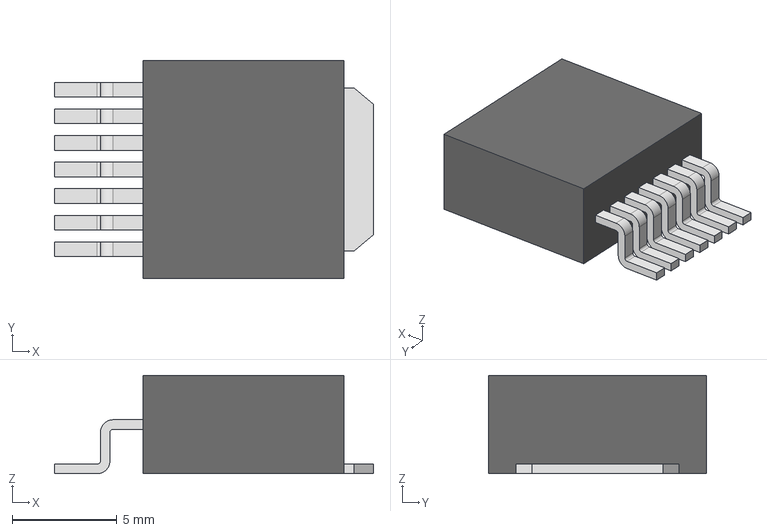
[picture p122: CAD file, 2020-03-06]
CAD/components/TO127P1500X470-8N.step
15.2 x 10.4 x 4.70 mm
