ThomasKulin/CG-490/CAD/Prototype Clamp Head.stl

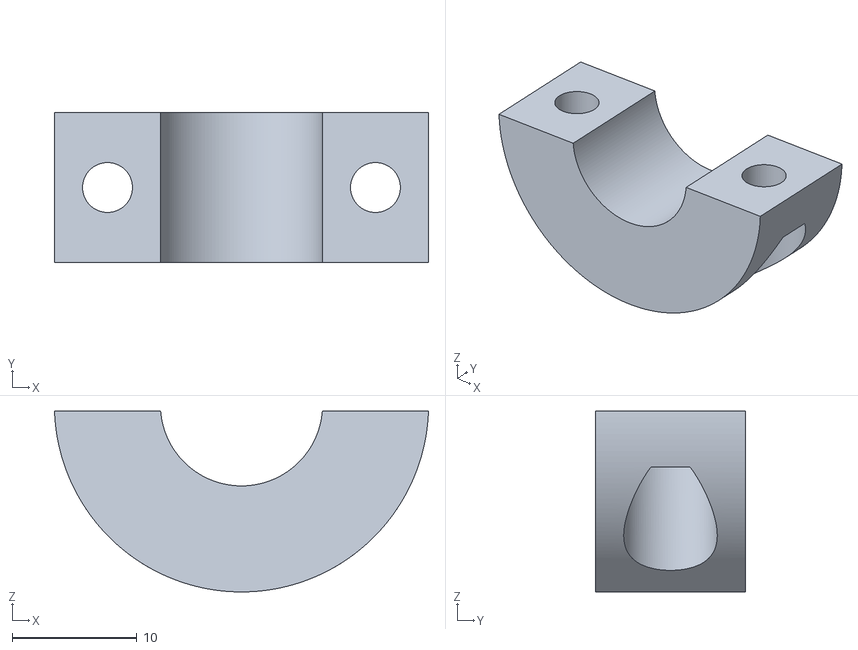
[picture p123: CAD file, 2020-09-17]
CAD/Prototype Clamp Head.stl
30.0 x 12.0 x 14.5
