ThomasKulin/CG-490/CAD/components/CAPPRD254W65D500H700B.step

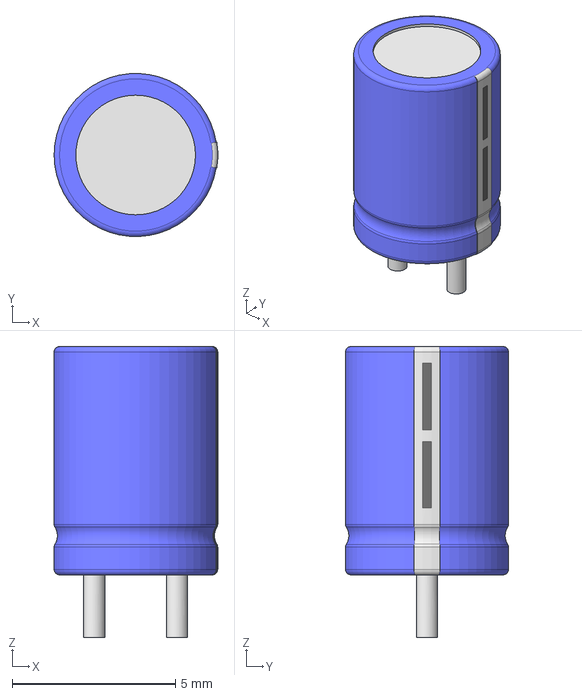
[picture p124: CAD file, 2020-03-06]
CAD/components/CAPPRD254W65D500H700B.step
5.02 x 4.99 x 8.92 mm
