ThomasKulin/CG-490/(list of files, cad)

Other CAD files:
CAD/Optics Assembly v1.stl
