ThomasKulin/CG-490/Report/CAD/Optics Assembly Drawing.PNG

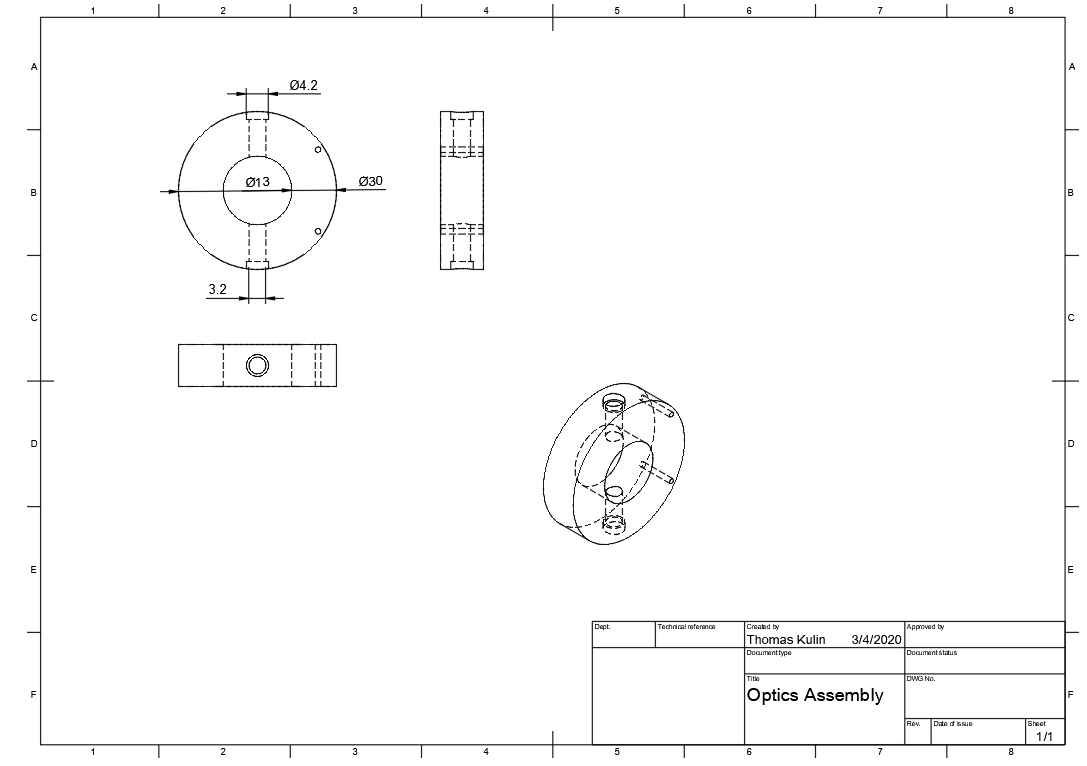
Report/CAD/Optics Assembly Drawing.PNG
