ThomasKulin/CG-490/Report/CAD/Single Coil Assembly.PNG

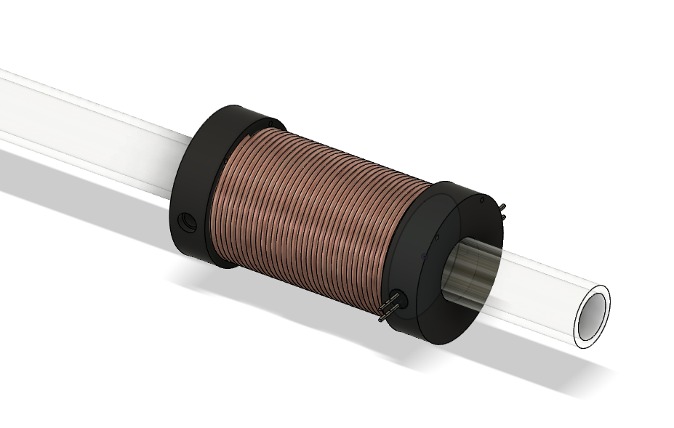
Report/CAD/Single Coil Assembly.PNG
