ThomasKulin/CG-490/Report/measurements/25V_TEST2.jpg

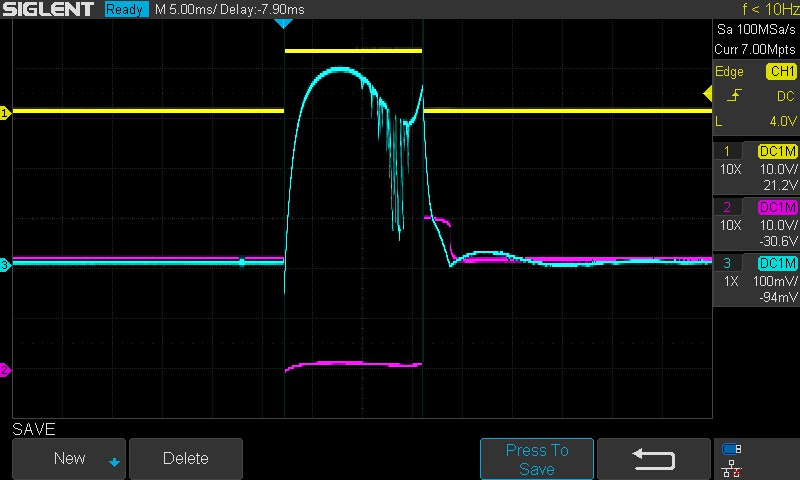
Report/measurements/25V_TEST2.jpg
