ThomasKulin/CG-490/Report/measurements/25V_TEST3.jpg

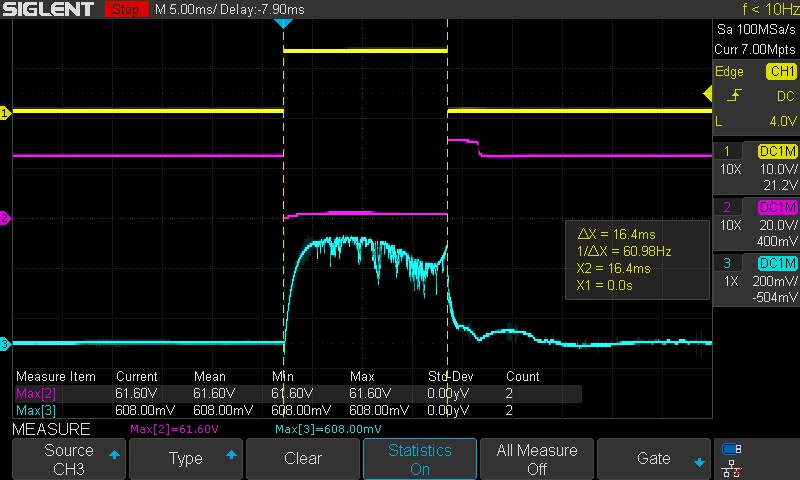
Report/measurements/25V_TEST3.jpg
