ThomasKulin/CG-490/Report/measurements/25V_TEST.jpg

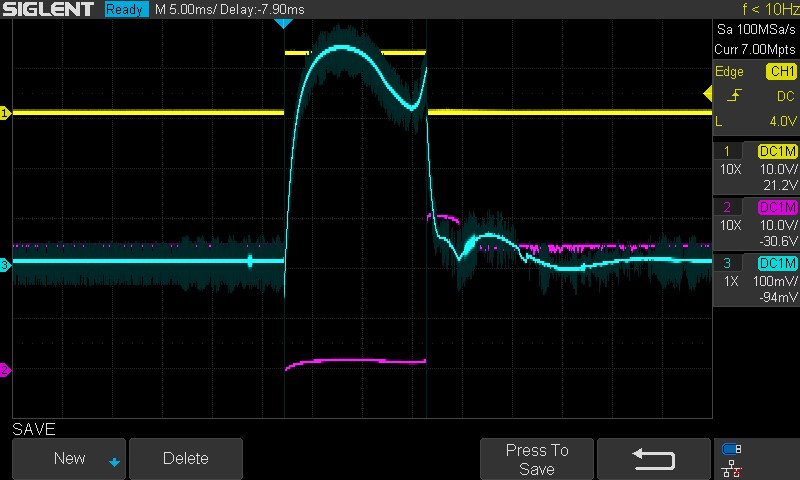
Report/measurements/25V_TEST.jpg
