ThomasKulin/CG-490/SPICE Simulations/OpticalSpeedometer.asc

D1: diode; 1N4148
I1: current; PULSE(6e-3 100e-9 1e-3 1e-5 1e-5 3e-3 0.1 2)
I2: current; PULSE(2e-3 100e-9 2.3e-3 1e-5 1e-5 3e-3 0.1 2)
R1: res; 2k
R2: res; 10k
R3: res; 6.8k
R4: res; 10k
R5: res; 4k
R6: res; 10k
R7: res; 6.8k
R8: res; 1k
R9: res; 2.2k
R10: res; 5k
U1: opamp2; LM393
U2: opamp2; LM393
V1: voltage; 12
Named nets: Vrx1, 0, Vref1, Trig1, Trig2, Vrx2, Vref2
.lib mylib\\OPAMP\\LM311.lib
.tran 20e-3
.lib mylib\\OPAMP\\LM393.lib
phototransistor
phototransistor
