ThomasKulin/CG-490/SPICE Simulations/OpticalSwitch.asc

C1: cap; 1e-5
I1: current; PULSE(10e-3 100e-9 1e-3 1e-3 1e-3 15e-3 0.1 2)
Q1: pnp; 2N3906
R1: res; 1k
R2: res; 10k
R3: res; 6.8k
R4: res; 10k
R5: res; 1k
R6: res; 1.5k
R7: res; 1k
R8: res; 2.2k
R9: res; 1k
R10: res; 5k
R11: res; 100k
U2: opamp2; LM393
U3: opamp2; LM393
V1: voltage; 12
Named nets: Vrx, Vtrigger, 0, Vout, Vref2, Vtiming, Vref
.lib mylib\\OPAMP\\LM311.lib
.tran 20e-3
.lib mylib\\OPAMP\\LM393.lib
phototransistor
