ThomasKulin/CG-490/SPICE Simulations/60V Zener Diode --Thermal Config.asc

D1: zener; 1N5371B
L1: ind; 40e-6; Rser=.08 Cpar=1e-9
M2: thermal-nmos; IPB180N10S4_02
R1: res; 4
U1: SOAtherm-PCB; Tambient=50 LFM=0 PCB_FR4_Thickness_mm=1.5
V1: voltage; PULSE(0 20 0.001 1e-5 1e-4 0.005 0 1); Rser=0.1`
V2: voltage; 50; Rser=.12
Named nets: 0, Vo, Vi, Tj
.lib mylib\\NMOS\\OptiMOS-T2_100V.lib
.tran 0 0.01 0 0.00001
