ThomasKulin/CG-490/SPICE Simulations/PowerSwitch V1.asc

D1: zener; SMDJ24A
D2: zener; SMDJ24A
L1: ind; 40e-6; Rser=.08 Cpar=1e-9
M1: thermal-nmos; STP310N10F7_V3
M2: thermal-nmos; IPB180N10S4_02
R1: res; 1; tol=1 pwr=0.1
U1: SOAtherm-PCB; Area_Contact_mm2=100 Area_PCB_mm2=10000 Copper_Thickness_oz=1; Tambient=25 LFM=0 PCB_FR4_Thickness_mm=1.5
V1: voltage; PULSE(0 18 0.001 40e-8 40e-8 0.003 0 1); Rser=2
V2: voltage; 50; Rser=.12
Named nets: 0, Vo, Vg, Tj, Tcase
.lib mylib\\NMOS\\OptiMOS-T2_100V.lib
.tran 0 0.006 0 0.00001
.lib mylib\\TVS\\SMDJXXXA.lib
.lib mylib\\NMOS\\STP310N10F7_V3.lib
