ThomasKulin/CG-490/SPICE Simulations/Push Pull Config.asc

L1: ind; 40e-6; Rser=.2 Cpar=1e-9
M1: nmos; IPB180N10S4_02_L0
M2: nmos; IPB180N10S4_02_L0
R1: res; 4
R2: res; 4
V1: voltage; PULSE(0 20 0.001 1e-7 1e-7 0.005 0 1); Rser=0.1
V2: voltage; 50; Rser=.12
V3: voltage; PULSE(20 0 0.001 1e-5 1e-7 0.005 0 1); Rser=0.1
Named nets: 0, Vo, Vi, Vi_INV
.lib C:\\Users\\ekultho\\Documents\\LTspiceXVII\\mylib\\NMOS\\OptiMOS-T2_100V.lib
.tran 0 0.01 0 0.00001
