ThomasKulin/CG-490/FEMM Simulations/SPICE Dependencies/offTime.asc

D1: zener; SMDJ24A
D2: zener; SMDJ24A
L1: ind; {L_COIL}; Rser={R_COIL} Cpar=1e-9
V2: voltage; 50; Rser=.12
Named nets: Vo, 0
.tran 0 0.04 0 0.00001
.lib SMDJXXXA.lib
.ic I(L1) = I_COIL
.param I_COIL=184.67845153808594
.param L_COIL=0.00012000000000000002
.param R_COIL=0.1477888900103919
