ThomasKulin/CG-490/FEMM Simulations/SPICE Dependencies/onTime.asc

L1: ind; {L_COIL}; Rser={R_COIL} Cpar=1e-9
M1: thermal-nmos; STP310N10F7_V3
M2: thermal-nmos; IPB180N10S4_02
U1: SOAtherm-PCB; Area_Contact_mm2=100 Area_PCB_mm2=10000 Copper_Thickness_oz=1; Tambient=25 LFM=0 PCB_FR4_Thickness_mm=1.5
V1: voltage; 20
V2: voltage; 50; Rser=.12
Named nets: 0, Vo, Tj, Tcase
.lib OptiMOS-T2_100V.lib
.tran 0 0.04 0 0.00001
.lib STP310N10F7_V3.lib
.ic I(L1) = I_COIL
.param I_COIL=0
.param L_COIL=0.00012000000000000002
.param R_COIL=0.1477888900103919
