ThomasKulin/CG-490/SPICE Simulations/mylib/LTC4441.asc

C1: cap; 10µ
C2: cap; 100µ
C3: cap; .0047µ
D1: schottky; MBR745
L1: ind; 10µ; Rpar=2K
Q1: nmos; Si7370DP
R1: res; 5m
R2: res; 100K
R3: res; 86.6K
R4: res; 330K
R5: res; 100K
R6: res; 20K
R7: res; 100
R8: res; 8.06K
R9: res; 511K
R10: res; 56K
R11: res; 26
U1: LTC4441
U2: LTC3803
V1: voltage; 15
Named nets: 0, OUT, IN
.tran 10.m startup
Note:
  If the simulation model is not found please update with the "Sync Release" command from the "Tools" menu.
  It remains the customer's responsibility to verify proper and reliable operation in the actual application.
  Component substitution and printed circuit board layout may significantly affect circuit performance or reliability
  Contact your local sales representative for assistance. This circuit is distributed to customers only for use with LTC parts
  Copyright © 2006, 2014 Linear Technology Inc. All rights reserved.
LTC4441 - N-Channel MOSFET Gate Driver
LTC3803 - Constant Frequency Current Mode Flyback DC/DC Controller
Boost Converter with N-Channel MOSFET Gate Driver
Input: 6V to 24V     Output: 52V @ 2A
