ThomasKulin/CG-490/Eagle/CG-490/PowerSwitchV1.brd

## EAGLE design Eagle/CG-490/PowerSwitchV1.brd (2020-03-22)

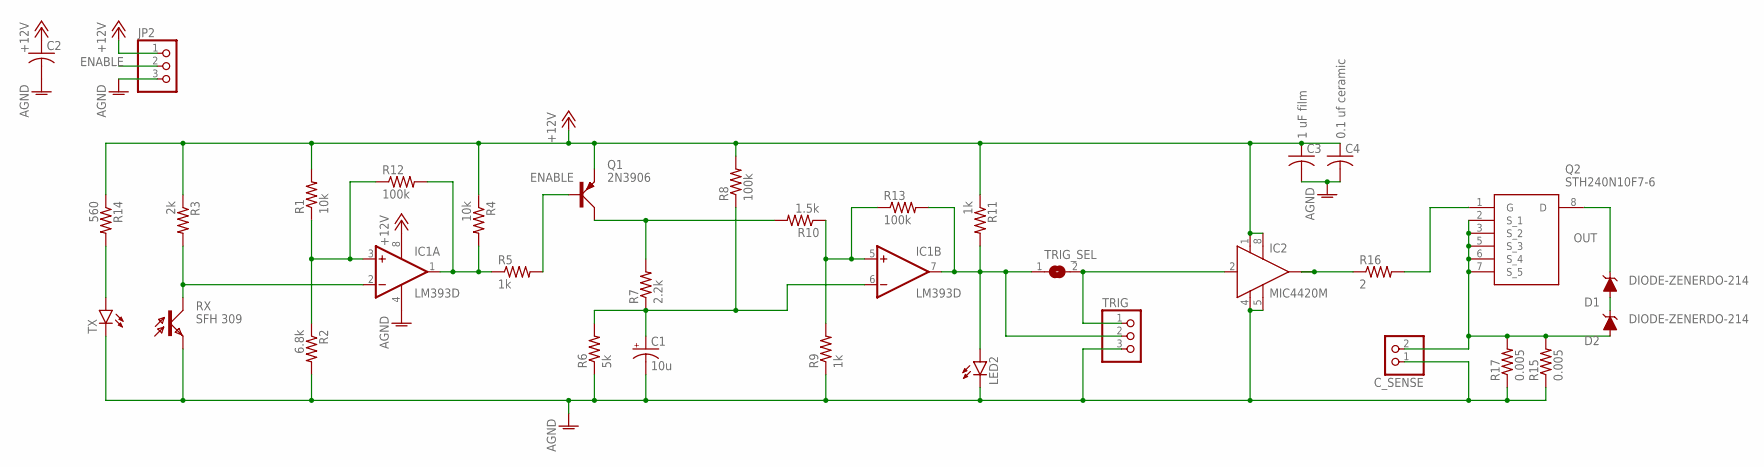
[picture p130: schematic PowerSwitchV1.sch]

Parts:
C1: 10u; TT2D6
C2: C-US050-050X075; C050-050X075
C3: 1 uF film; C050-045X075
C4: 0.1 uf ceramic; C025-030X050
C_SENSE: PINHD-1X2; 1X02
D1, D2: DIODE-ZENERDO-214; SMA-DIODE
IC1: LM393D; SO08
IC2: MIC4420M; SO-08
JP2: PINHD-1X3; 1X03
LED2: LEDCHIPLED_0603; CHIPLED_0603
Q1: 2N3906; TO92D
Q2: STH240N10F7-6; H2PAK-6_1
R1, R4: 10k; R0603
R2: 6.8k; R0603
R3: 2k; R0603
R5, R9, R11: 1k; R0603
R6: 5k; R0603
R7: 2.2k; R0603
R8, R12, R13: 100k; R0603
R10: 1.5k; R0603
R14: 560; R0603
R15, R17: 0.005; R1206
R16: 2; M0805
RX: SFH 309; BPX81
TRIG: PINHD-1X3; 1X03
TRIG_SEL: SJ
TX: LED3MM

Connections:
+12V: C2.1, C3.1, C4.1, IC1.8 (V+), IC2.1 (VS), IC2.8 (VS1), JP2.1, Q1.E, R1.2, R3.1, R4.1, R8.2, R11.1, R14.1
AGND: C1.-, C2.2, C3.2, C4.2, C_SENSE.1, IC1.4 (V-), IC2.4 (GND), IC2.5 (GND1), JP2.3, LED2.C, R2.2, R6.1, R9.1, R15.1, R17.1, RX.E, TRIG.3, TX.K (C)
ENABLE: JP2.2, Q1.B, R5.2
unnamed: IC1.2 (-IN), R3.2, RX.C
unnamed: IC2.2 (IN), TRIG.1, TRIG_SEL.2
unnamed: IC1.3 (+IN), R1.1, R2.1, R12.1
unnamed: IC2.6 (OUT), IC2.7 (OUT), R16.1
unnamed: IC1.1 (OUT), R4.2, R5.1, R12.2
unnamed: Q1.C, R7.2, R10.2
unnamed: C1.+, IC1.6 (-IN), R6.2, R7.1, R8.1
unnamed: R14.2, TX.A
unnamed: D1.A, D2.C
unnamed: IC1.5 (+IN), R9.2, R10.1, R13.1
unnamed: IC1.7 (OUT), LED2.A, R11.2, R13.2, TRIG.2, TRIG_SEL.1
unnamed: C_SENSE.2, D2.A, Q2.2 (S_1), Q2.3 (S_2), Q2.5 (S_3), Q2.6 (S_4), Q2.7 (S_5), R15.2, R17.2
unnamed: Q2.1 (G), R16.2
OUT: D1.C, Q2.8 (D)

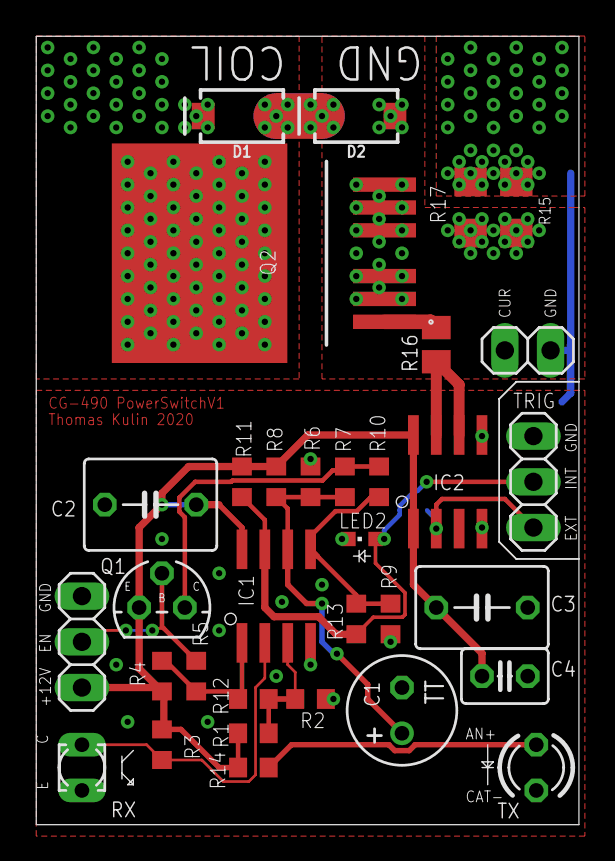
[picture p131: board PowerSwitchV1.brd from above]

Board: 2 copper layers, 30.1 x 43.8 mm, 34 parts (1 on the bottom side), 17 nets.
