ThomasKulin/CG-490/Eagle/CG-490/OpticalSpeedometerV1.brd

## EAGLE design Eagle/CG-490/OpticalSpeedometerV1.brd (2020-03-22)

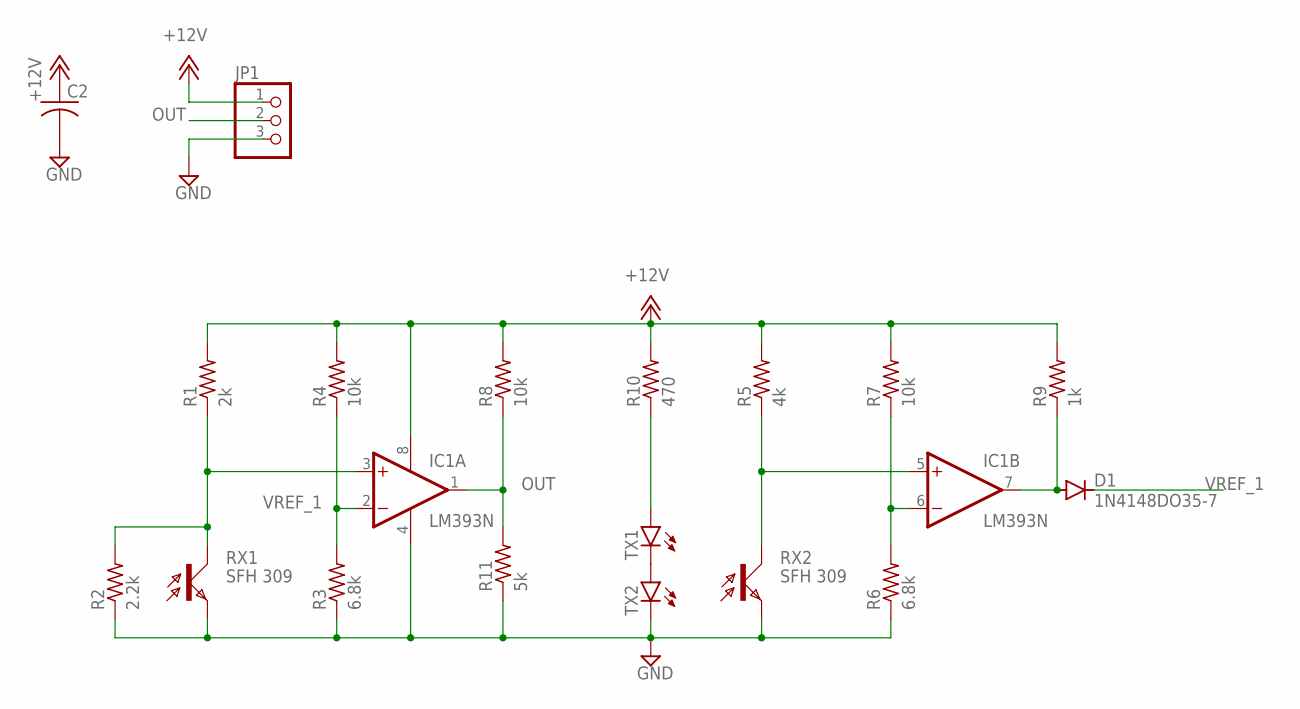
[picture p132: schematic OpticalSpeedometerV1.sch]

Parts:
C2: C-US050-050X075; C050-050X075
D1: 1N4148DO35-7; DO35-7
IC1: LM393N; DIL08
JP1: PINHD-1X3; 1X03
R1: 2k; 0204/5
R2: 2.2k; 0204/5
R3, R6: 6.8k; 0204/5
R4, R7, R8: 10k; 0204/5
R5: 4k; 0204/5
R9: 1k; 0204/5
R10: 470; 0204/5
R11: 5k; 0204/5
RX1, RX2: SFH 309; BPX81
TX1, TX2: LED3MM

Connections:
+12V: C2.1, IC1.8 (V+), JP1.1, R1.2, R4.2, R5.2, R7.2, R8.2, R9.2, R10.2
GND: C2.2, IC1.4 (V-), JP1.3, R2.1, R3.1, R6.1, R11.1, RX1.E, RX2.E, TX2.K (C)
unnamed: TX1.K (C), TX2.A
unnamed: IC1.3 (+IN), R1.1, R2.2, RX1.C
unnamed: R10.1, TX1.A
unnamed: IC1.5 (+IN), R5.1, RX2.C
unnamed: IC1.6 (-IN), R6.2, R7.1
unnamed: D1.A, IC1.7 (OUT), R9.1
OUT: IC1.1 (OUT), JP1.2, R8.1, R11.2
VREF_1: D1.C, IC1.2 (-IN), R3.2, R4.1

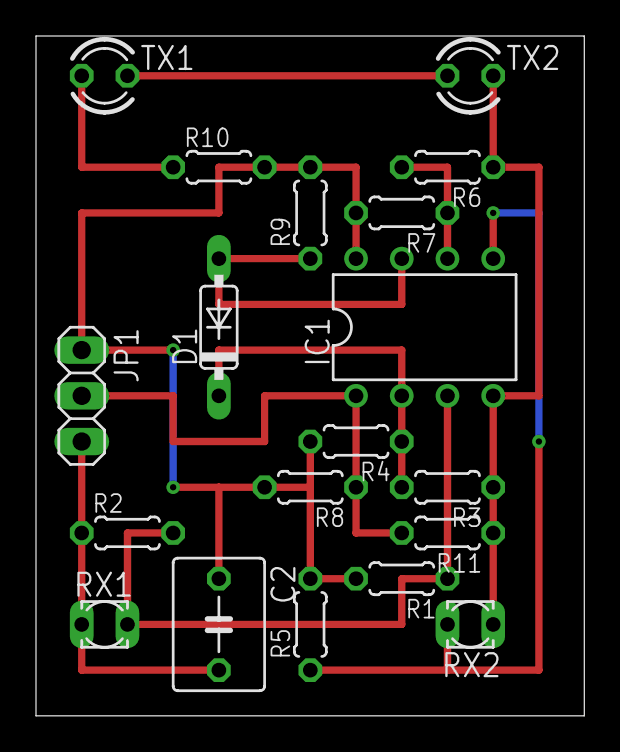
[picture p133: board OpticalSpeedometerV1.brd from above]

Board: 2 copper layers, 30.5 x 37.8 mm, 19 parts (0 on the bottom side), 10 nets.
