ThomasKulin/CG-490/Eagle/CG-490/SwitchV1.brd

## EAGLE design Eagle/CG-490/SwitchV1.brd (2020-01-31)

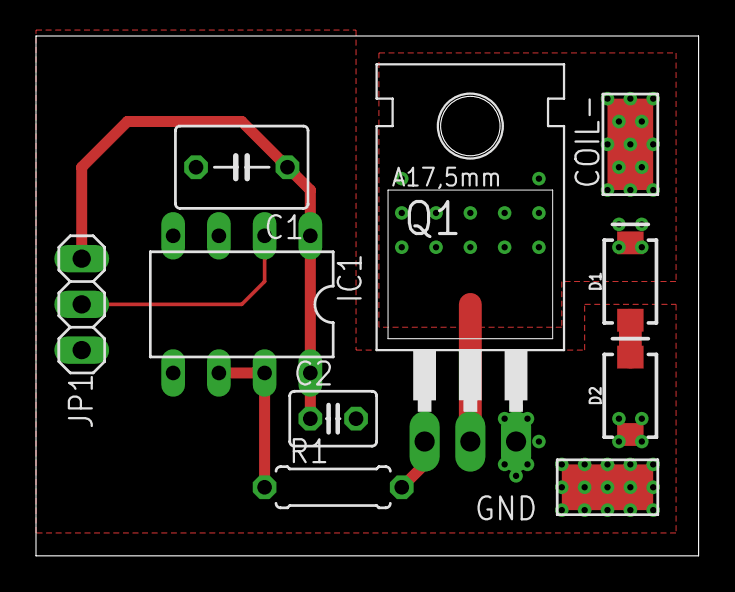
[picture p134: board SwitchV1.brd from above]

Board: 2 copper layers, 36.8 x 28.9 mm, 10 parts (0 on the bottom side), 7 nets.

Parts:
C1: 1 uF film; C050-045X075
C2: 0.1 uf ceramic; C025-030X050
COIL-: WIREPADSMD5-2,5; 5-2,5
D1, D2: DIODE-ZENERDO-214; SMA-DIODE
GND: WIREPADSMD5-2,5; 5-2,5
IC1: MIC4420N; DIL08
JP1: 1X03
Q1: IRF540; TO220
R1: 1; 0207/7

Connections:
+18V: C1.1, C2.1, IC1.1, IC1.8, JP1.1
GND: C1.2, C2.2, D2.A, GND.1, IC1.4, IC1.5, JP1.3, Q1.3
unnamed: IC1.6, IC1.7, R1.1
unnamed: Q1.1, R1.2
unnamed: D1.A, D2.C
unnamed: IC1.2, JP1.2
OUT: COIL-.1, D1.C, Q1.2
