ThomasKulin/CG-490/(commit log)

2019-10-16 preliminary SPICE and FEMM simulations along with python automated tests in progress
    [3.2mmCoil_100T_165A.xlsx, 3.2mmCoil_100T_246A.xlsx, 7mmCoil_192T_156A.xlsx, 7mmCoil_192T_156A_swIronThickness.xlsx, 7mmCoil_192T_156A_swProjectileLength.xlsx, 7mmCoil_192T_156A_swWallThickness.xlsx, 7mmCoil_192T_156A_timeSweep.xlsx, Run1_CG_ovvw.csv]
2019-10-17 updated time sweep test, added thermal model to simulations
    [3.2mmCoil_100T_165A.xlsx, 3.2mmCoil_100T_246A.xlsx, timeSweepTemplate.xlsx]
2019-10-21 dimensional sweep test functional. need to add better data capture
    [40uH_Dimensions.xlsx, 7mmCoil_192T_156A_swIronThickness.xlsx]
2019-10-22 ran some simulations to determine optimal projectile diameter for a 40uH coil, 12mm seems like the sweet spot. need to sweep length at that radius
    [40uH_Dimensions.xlsx]
2019-10-23 Started writing the simulation writeup report
    [32mm_rad_vs_ind.xlsx, 60uH_Dimensions.xlsx, 7mmCoil_192T_156A_swProjectileLength.xlsx]
2019-10-29 added prototype switch schematic
    [SwitchV1.brd, SwitchV1.sch]
2019-10-30 added prototype layout and added to report
2019-10-30 started FEMM sim write-up, finished switch sim write-up
    [60uH_Dimensions.xlsx, 7mmCoil_192T_156A_swProjectileLength.xlsx, 7mmCoil_192T_156A_swWallThickness.xlsx]
2019-10-31 added fixed resistance mode for FEMM sims
2019-11-01 fixed fixedresistance mode. captured length dimension sweep with constant resistance. wrote some stuff. hi thomas
    [3.2mmCoil_100T_246A.xlsx, 7mmCoil_192T_156A_swProjectileLength.xlsx, 7mmCoil_192T_156A_swWallThickness.xlsx, 7mmCoil_192T_156A_timeSweep.xlsx, R0.1 Dimensions addon.xlsx, R0.1 Dimensions.xlsx]
2019-11-01 added some stuff but i dont remember what
    [40uH_Dimensions.xlsx, R0.1 Dimensions addon.xlsx, R0.1 Dimensions.xlsx, R0.1 swLength.xlsx, R0.1 swWidth.xlsx]
2019-11-05 added 2d plots for dimension sweep
    [60uH_Dimensions.xlsx, L40 swLength.xlsx, L40 swWidth.xlsx, R0.1 Dimensions.xlsx, R0.1 swLength.xlsx, R0.1 swWidth.xlsx]
2019-11-12 added LT Spice simulation integration into python scripts to facilitate more accurate simulation at higher inductances
    [Run1_CG_ovvw.csv, Run1_CG_res.csv]
2019-11-13 started updated timesweep test
    [swInductanceVsTime.xlsx]
2019-11-14 completed integration of current waveform in time based simulation. Next step is to make it multi stage
2019-11-14 got some nice data
    [swInductanceVsTime.xlsx]
2019-11-14 completed simultion of first stage, started simulation of subsequent stages, updated report
    [swInductanceVsTime.xlsx, swInductanceVsTimeAddon.xlsx, swInductanceVsTime_stage1.xlsx]
2019-11-20 not much
    [OpticalTriggerV1.sch]
2019-11-21 designed optical trigger with pulse limiting mechanism, ran LT simulations
    [copper_bottom.gbr, copper_top.gbr, drill_1_16.xln, gerber_job.gbrjob, profile.gbr, silkscreen_bottom.gbr, silkscreen_top.gbr, soldermask_bottom.gbr]
2019-11-22 updated optical switch schematic. needs better biasing on comparator 2 to ensure noise proof performance. also editing report.
2019-11-25 worked on report
    [swInductanceVsTime.xlsx]
2019-11-25 did some external iron testing for stage 1. Not feasible
    [swInductanceVsTime.xlsx, swInductanceVsTimeAddon.xlsx, swIronVsTime.xlsx]
2020-01-31 ran simulation of real world stage 1 design, created optical assembly CAD file
    [490 Preliminary Parts.xlsx, Optics Assembly v1.stl, SwitchV1.brd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]
2020-02-10 updated report with opt triggering circuit performance and finalized magnetic sim for first stage
    [Optics Assembly v2.stl]
2020-02-13 fuck, i just shorted the LIPO through a bunch of shit....
    [PulseGen.ino]
2020-03-05 layout for optical trigger and complete circuit underway
    [OpticalTriggerV1.brd, PowerSwitchV1.brd, PowerSwitchV1.sch]
2020-03-05 updated document with test results
    [swInductanceVsTime.xlsx]
2020-03-05 updated board layouts
    [PowerSwitchV1.brd, PowerSwitchV1.sch]
2020-03-06 updated components in 3d model of PCB
    [CAPPRD254W65D500H700B.step, TO127P1500X470-8N.step]
2020-03-10 finalized schematic/pcb, updated report
    [CL23B_72_100_50_V.stp, PowerSwitchV1.brd, PowerSwitchV1.sch]
2020-03-12 updated board layout
    [PowerSwitchV1.brd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]
2020-03-19 idk, just syncing
    [Project_Mar13_0205PM.xls]
2020-03-22 made optical speed sensor sim, circuit and perfboard layout
    [OpticalSpeedometerV1.brd, OpticalSpeedometerV1.sch, PowerSwitchV1.brd]
2020-09-17 updated report and made minor changes with the boys
    [Prototype Clamp Body.stl, Prototype Clamp Head.stl, final components order.xls, swInductanceVsTime.xlsx]
